Fuhua-Chen/ReSpeaker_Microphone_Array_SCH_PCB/README.md

# ReSpeaker_ReSpeaker_Microphone_Array_SCH_PCB
SCH, PCB and assembly files of ReSpeaker Microphone Array

## Requirements  
* Eagle v6.4 or later version

## Structure
* Folder SCH&PCB: sch, PCB and pdf built by Eagle
* Folder Assembly: Gerber, SMT coordinate, Assembly drawings
