Fuhua-Chen/ReSpeaker_Microphone_Array_SCH_PCB/assembly/319011550_PCB;Respeaker Microhone Array v1.0-哑光黑油白字-4层_元件位置图顶层.pdf

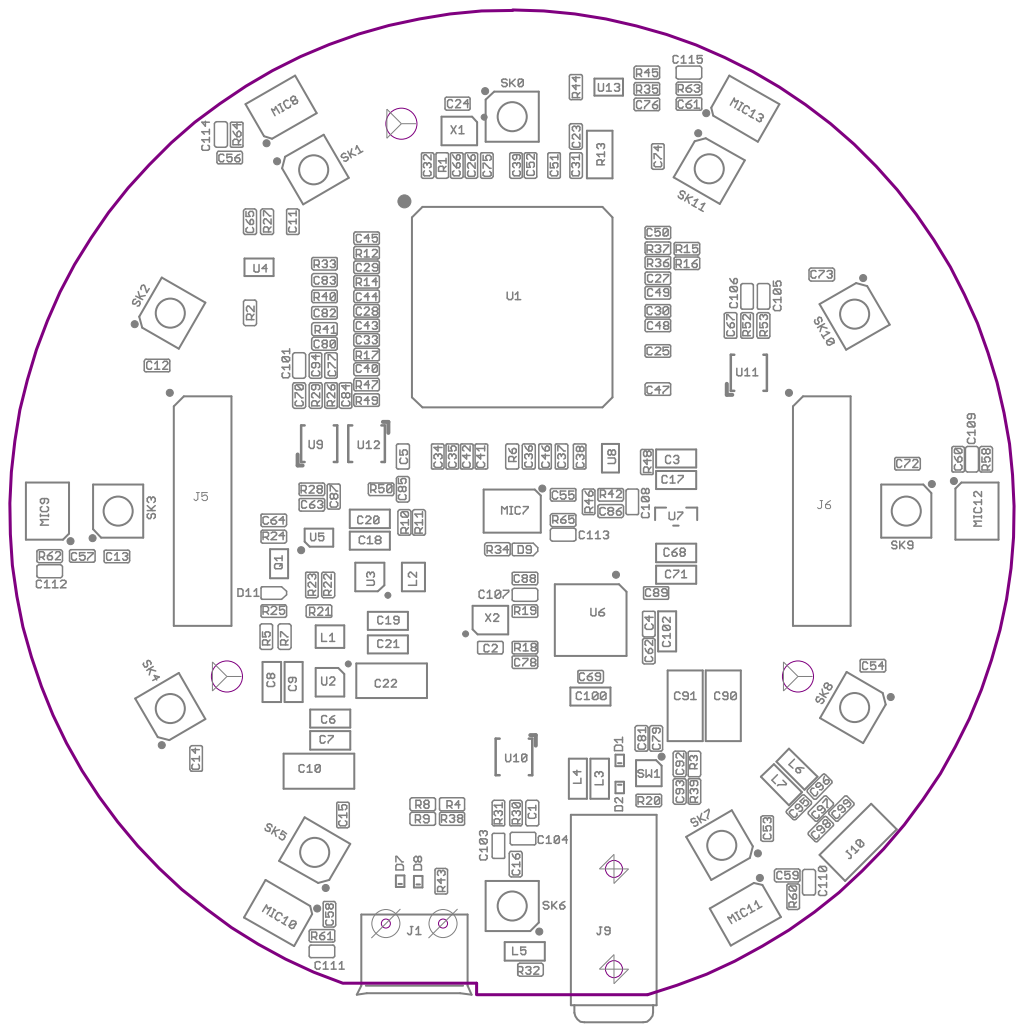
[picture p2: page 1]
