Fuhua-Chen/ReSpeaker_Microphone_Array_SCH_PCB/SCH&PCB/Respeaker Microphone Array v1.0.pdf

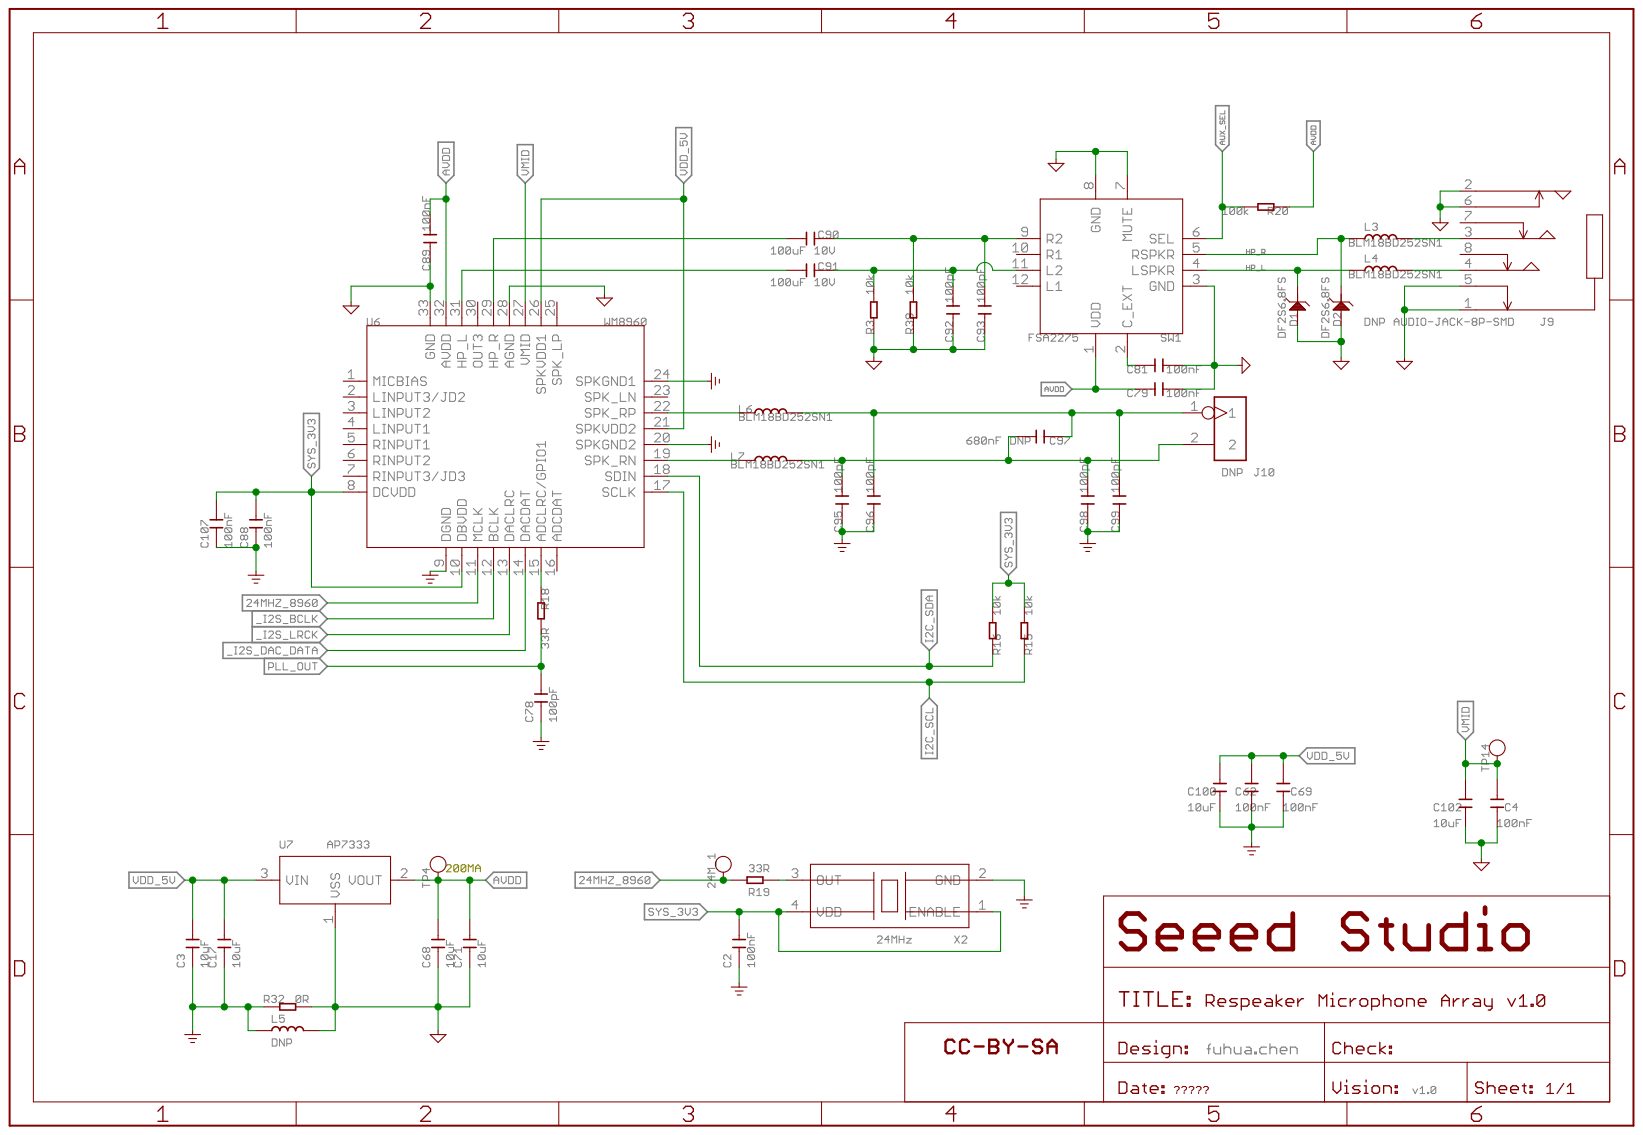
[picture p3: page 1]

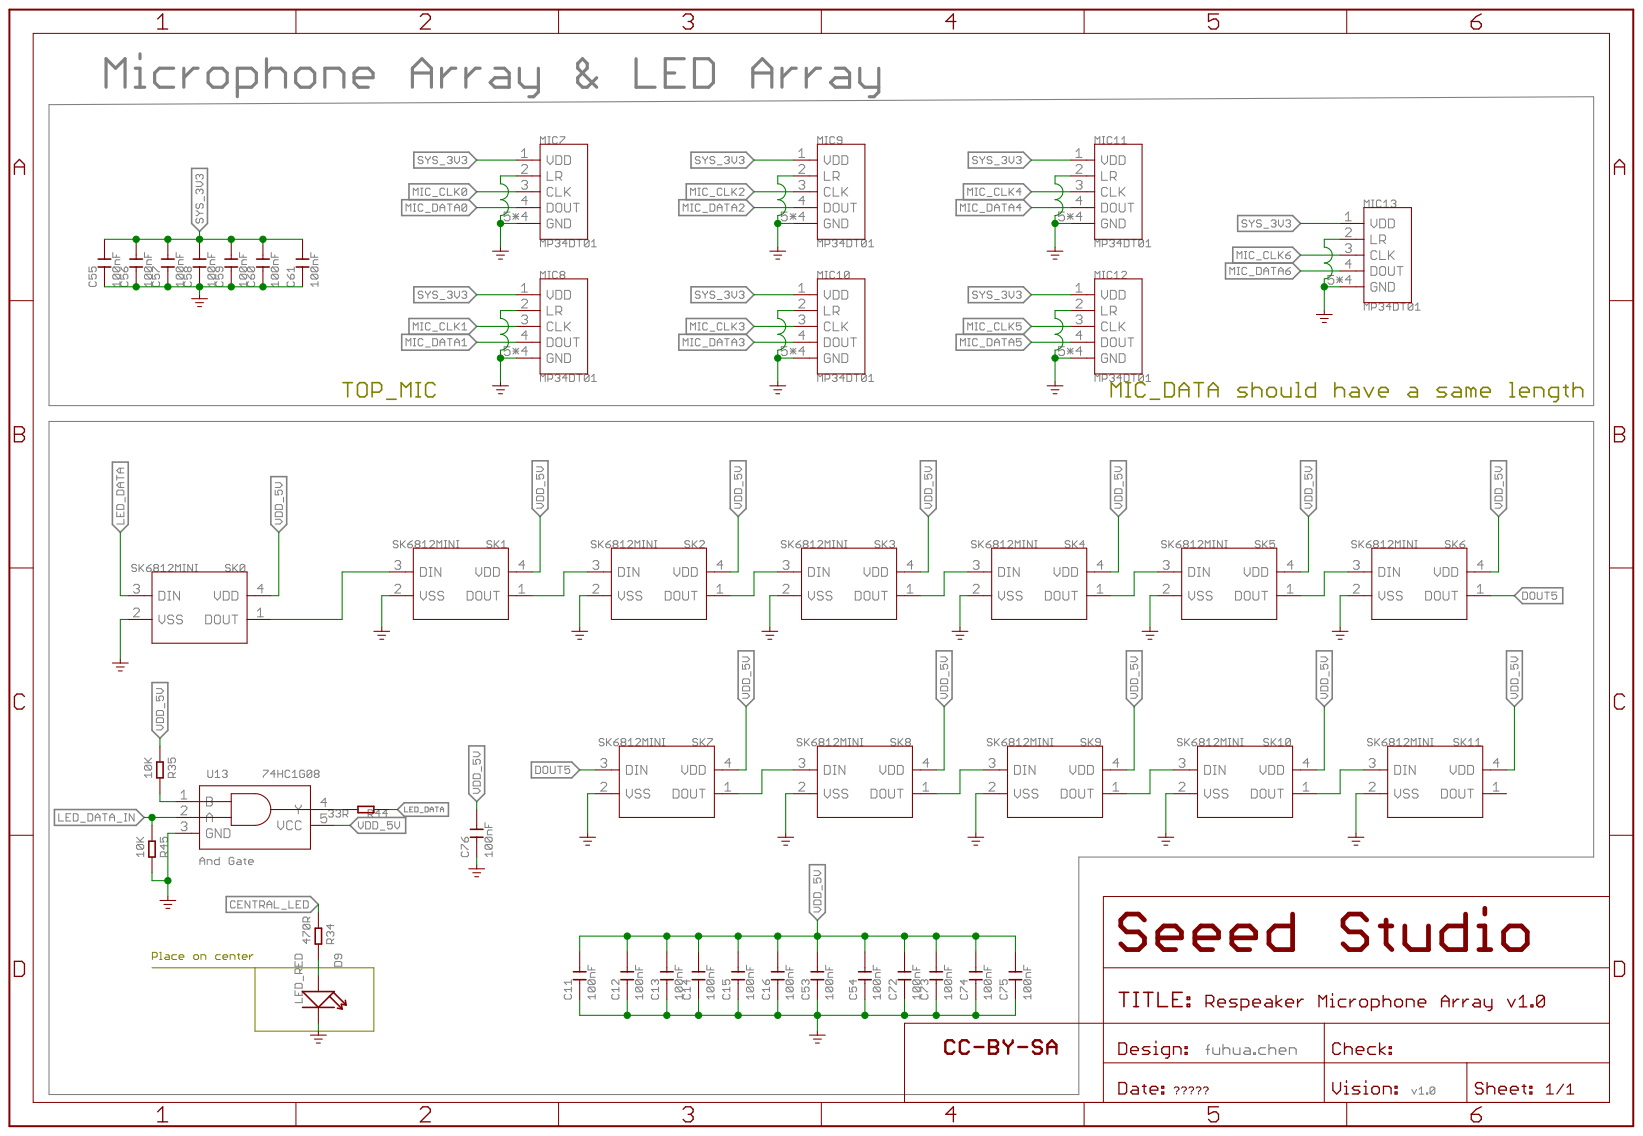
[picture p4: page 2]

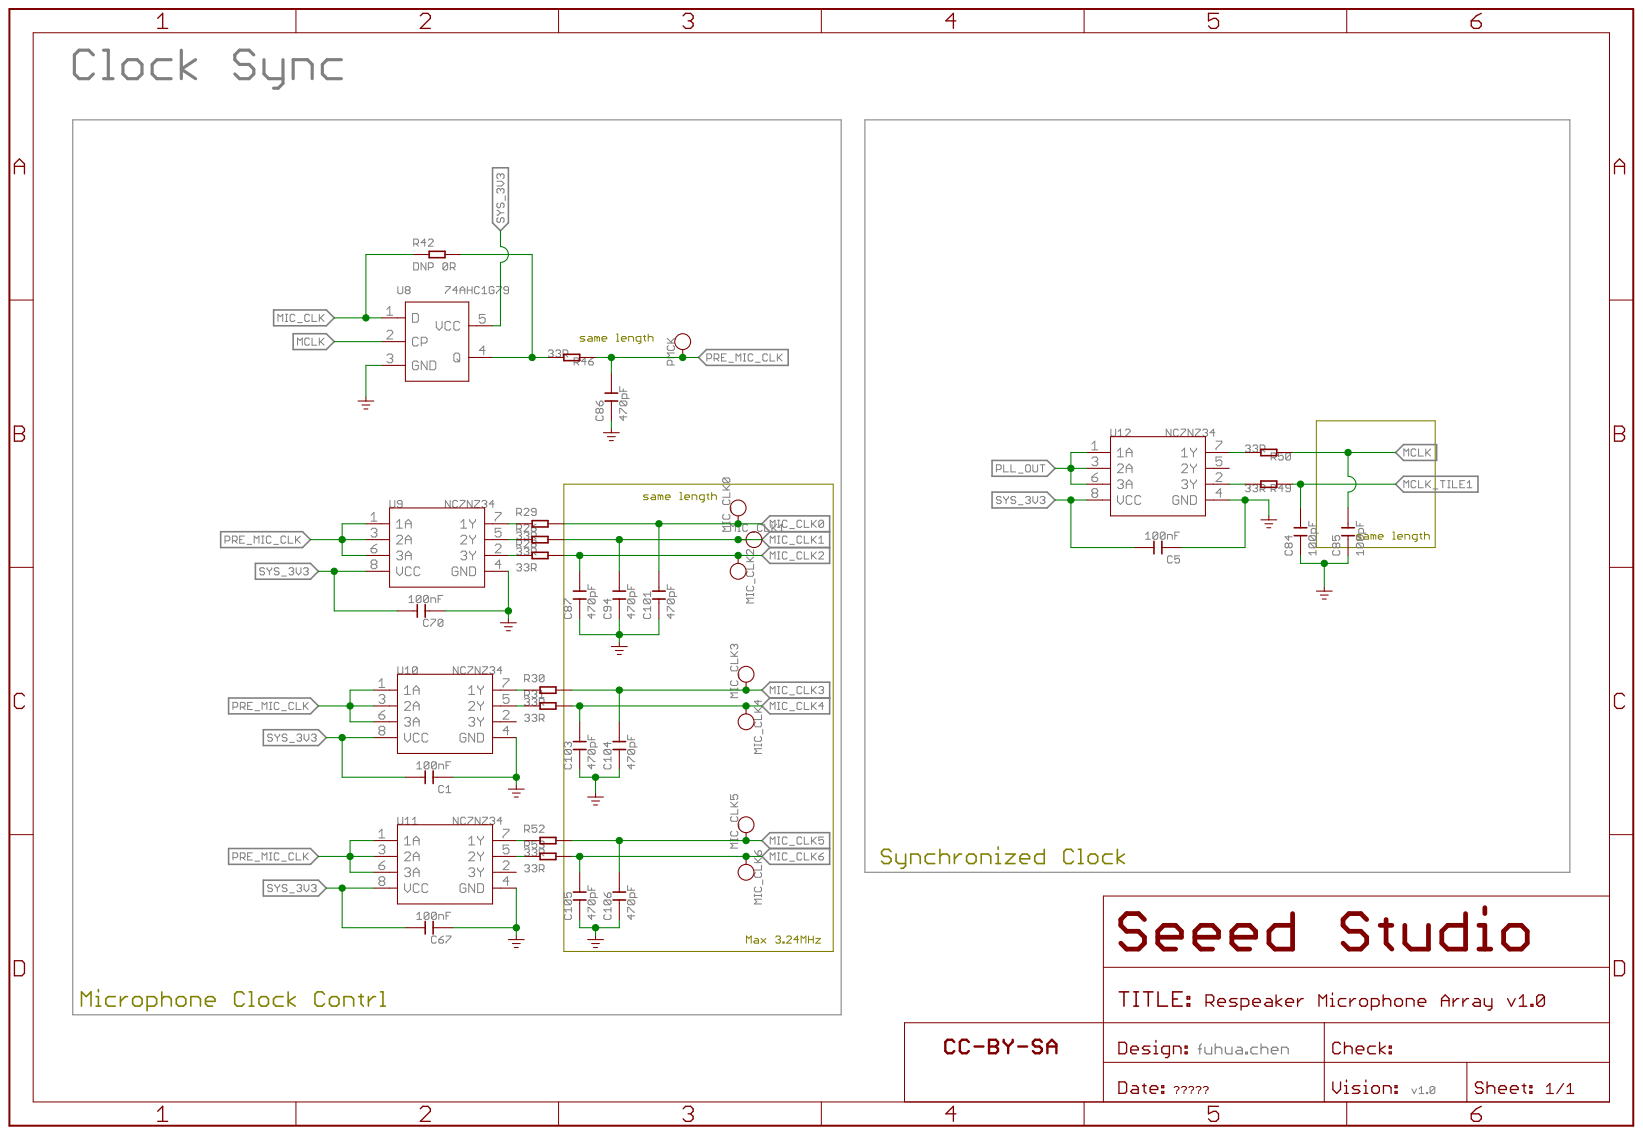
[picture p5: page 3]

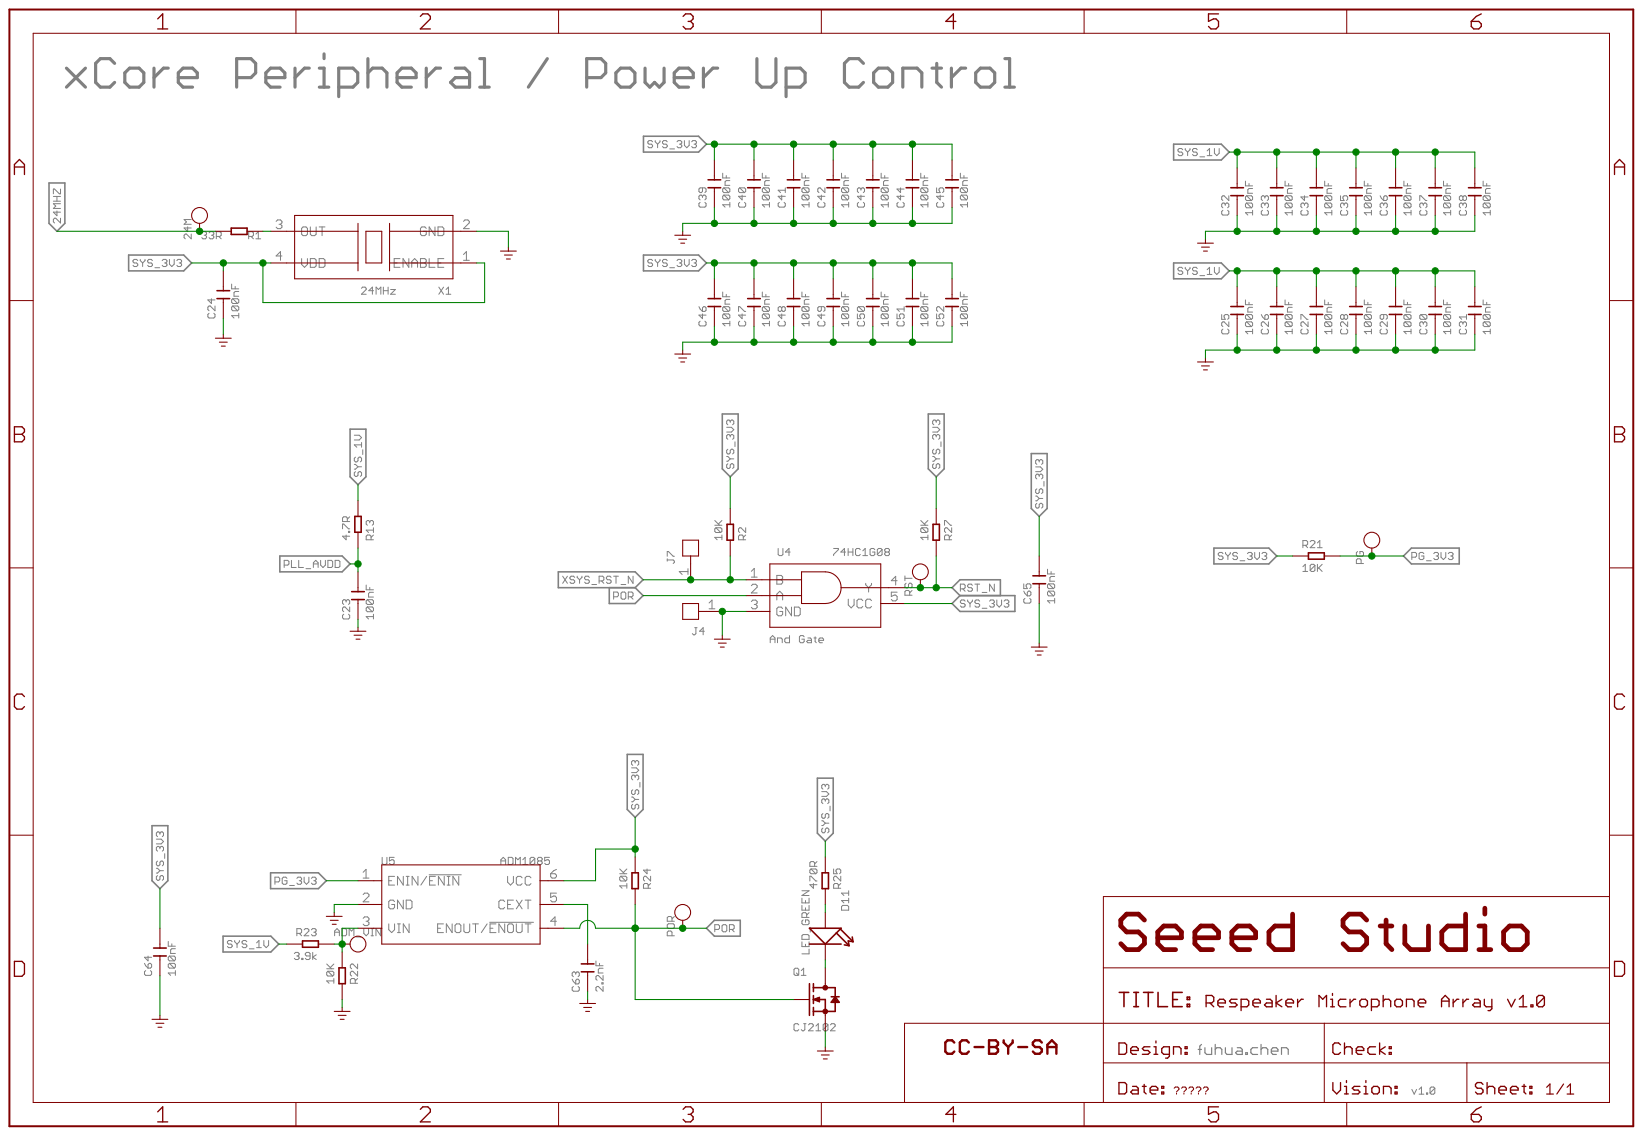
[picture p6: page 4]

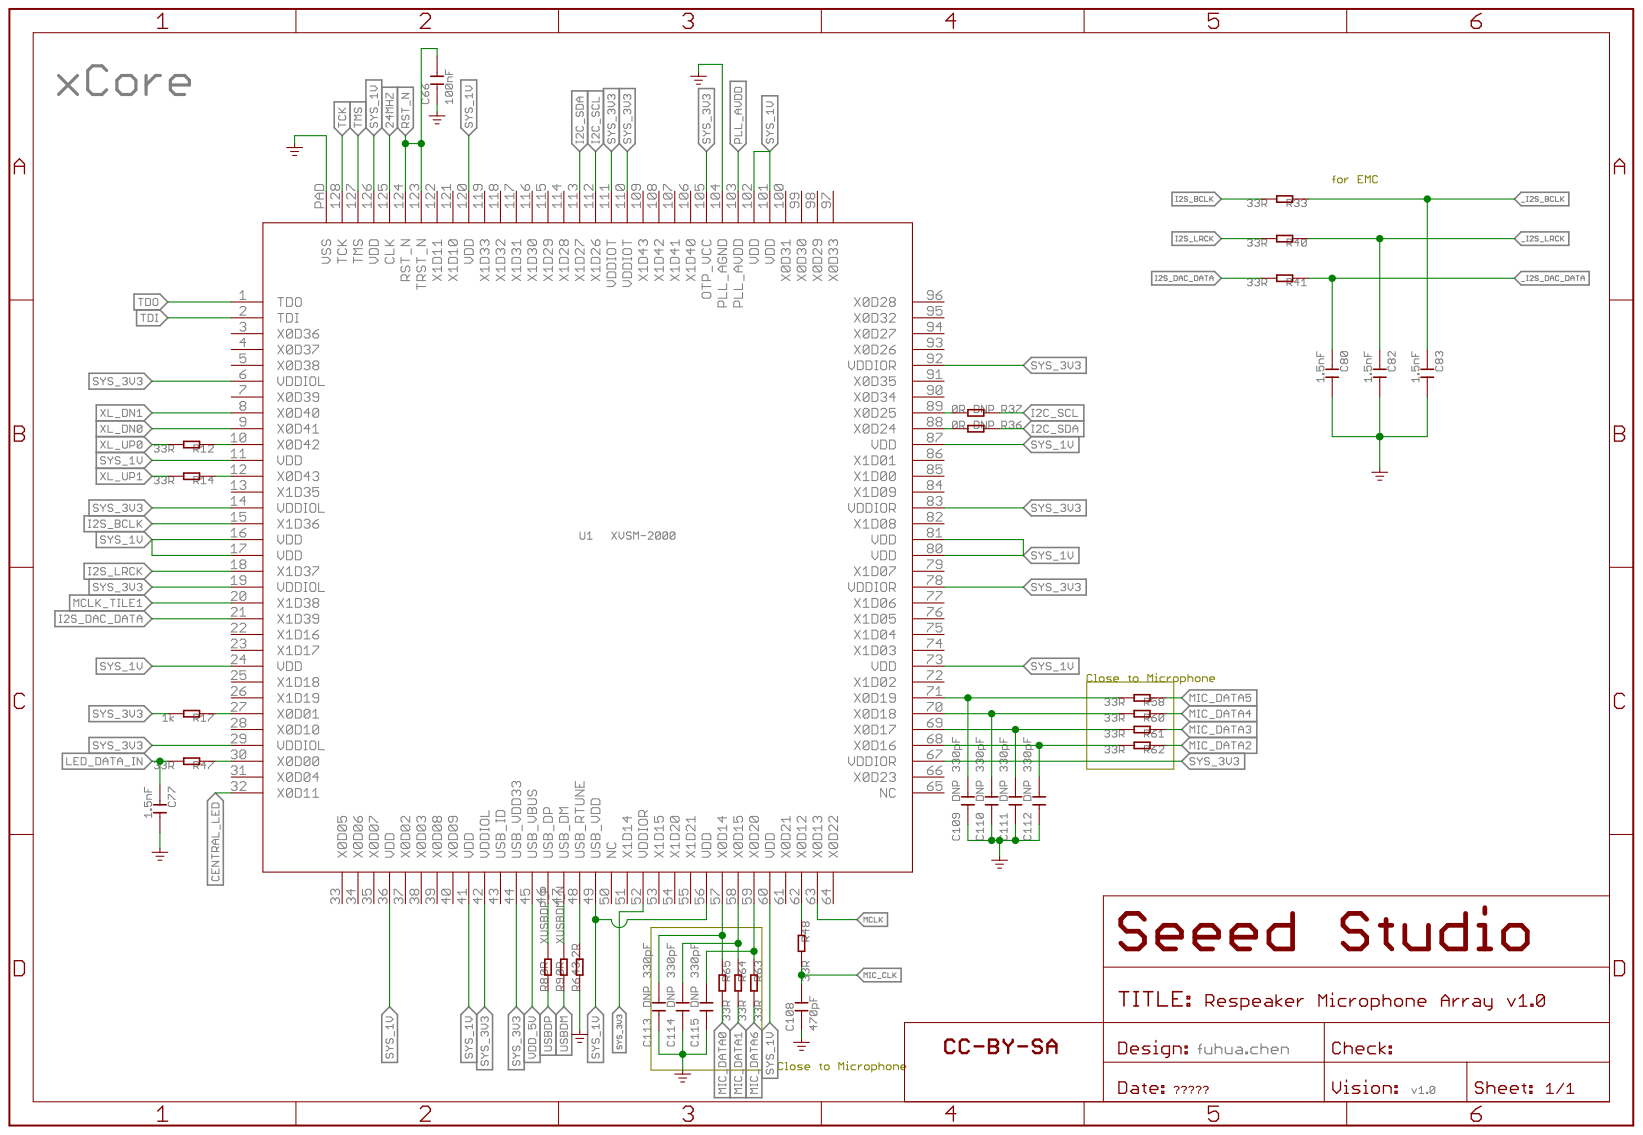
[picture p7: page 5]

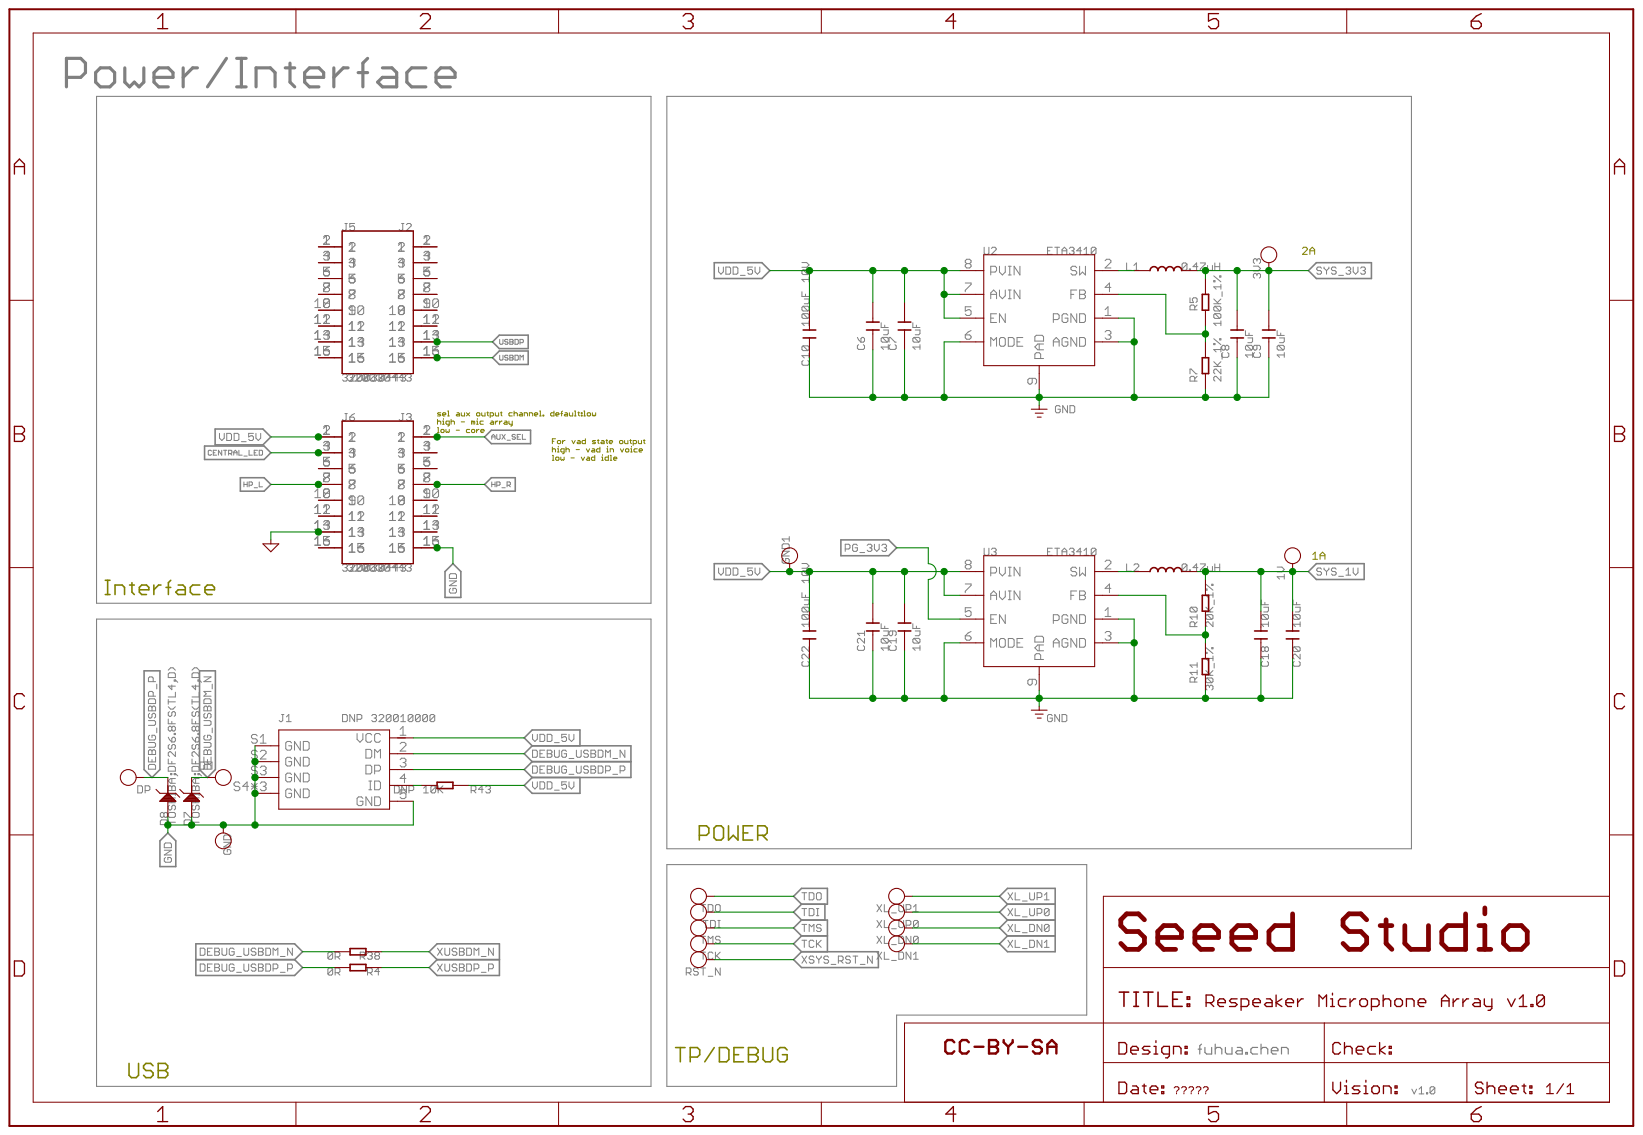
[picture p8: page 6]

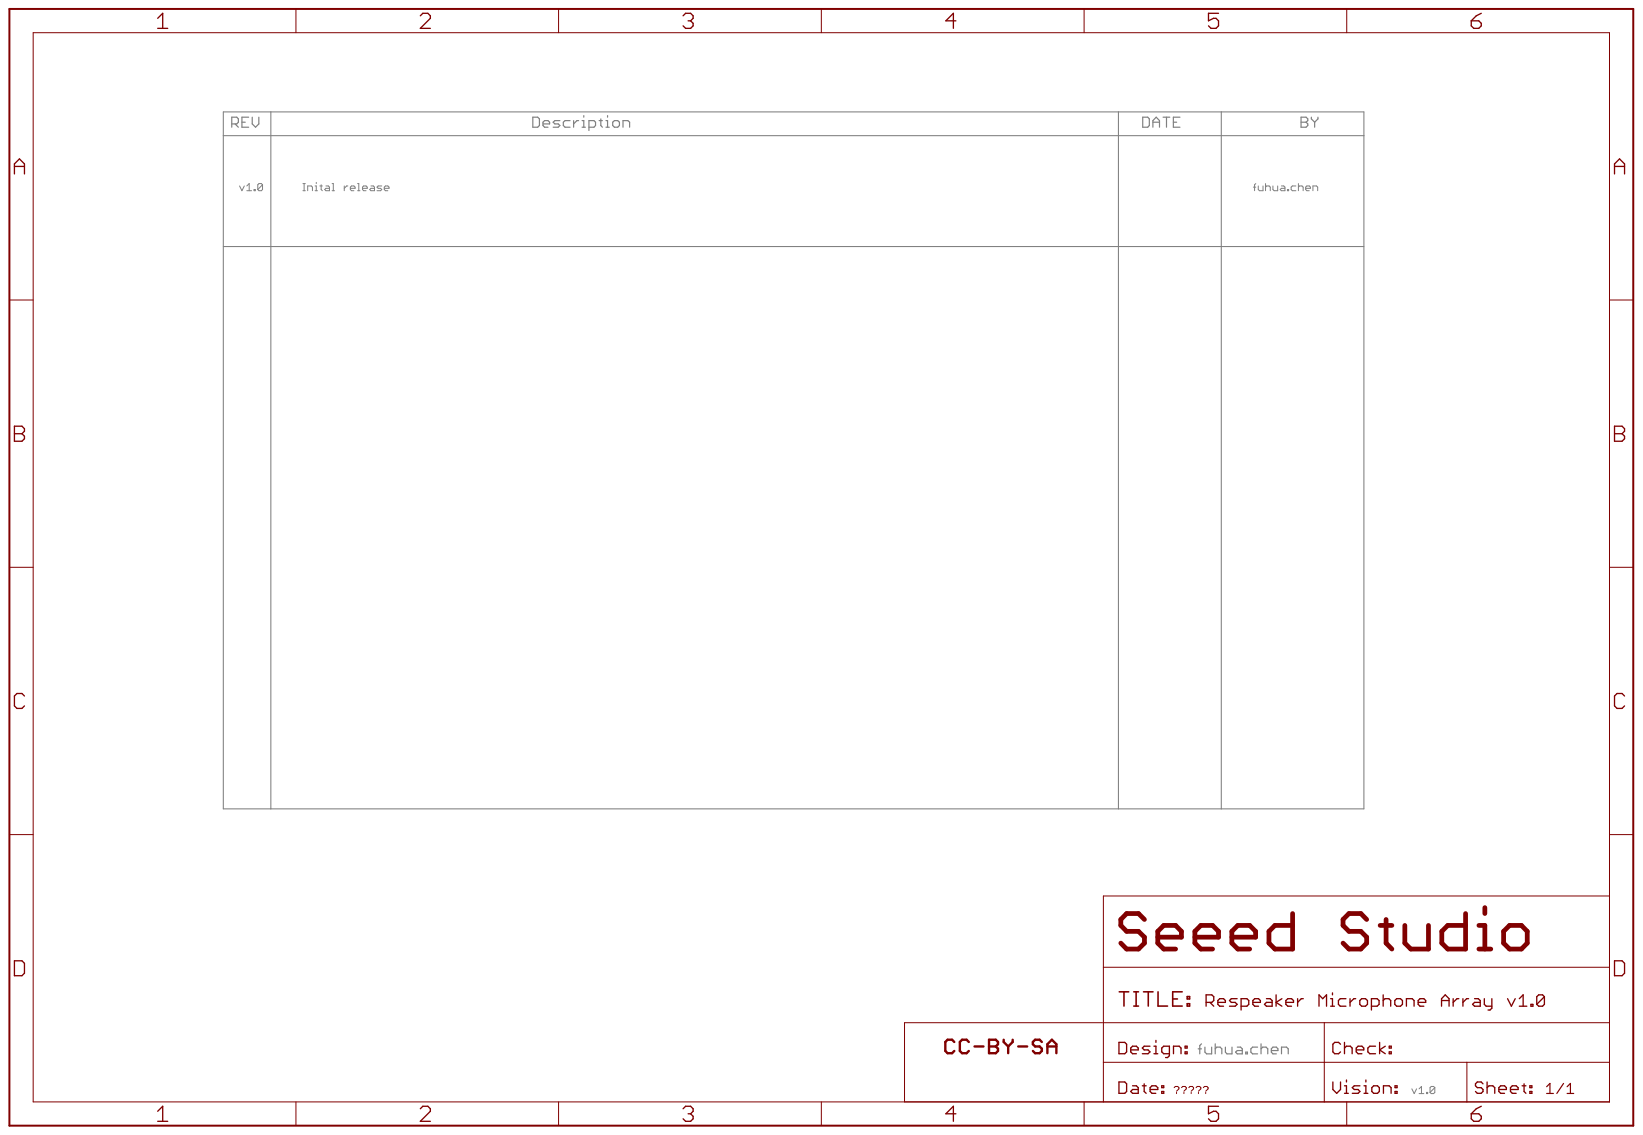
[picture p9: page 7]
