Fuhua-Chen/ReSpeaker_Microphone_Array_SCH_PCB/SCH&PCB/Respeaker Microphone Array v1.0.brd

## EAGLE design SCH&PCB/Respeaker Microphone Array v1.0.brd (2017-02-06)

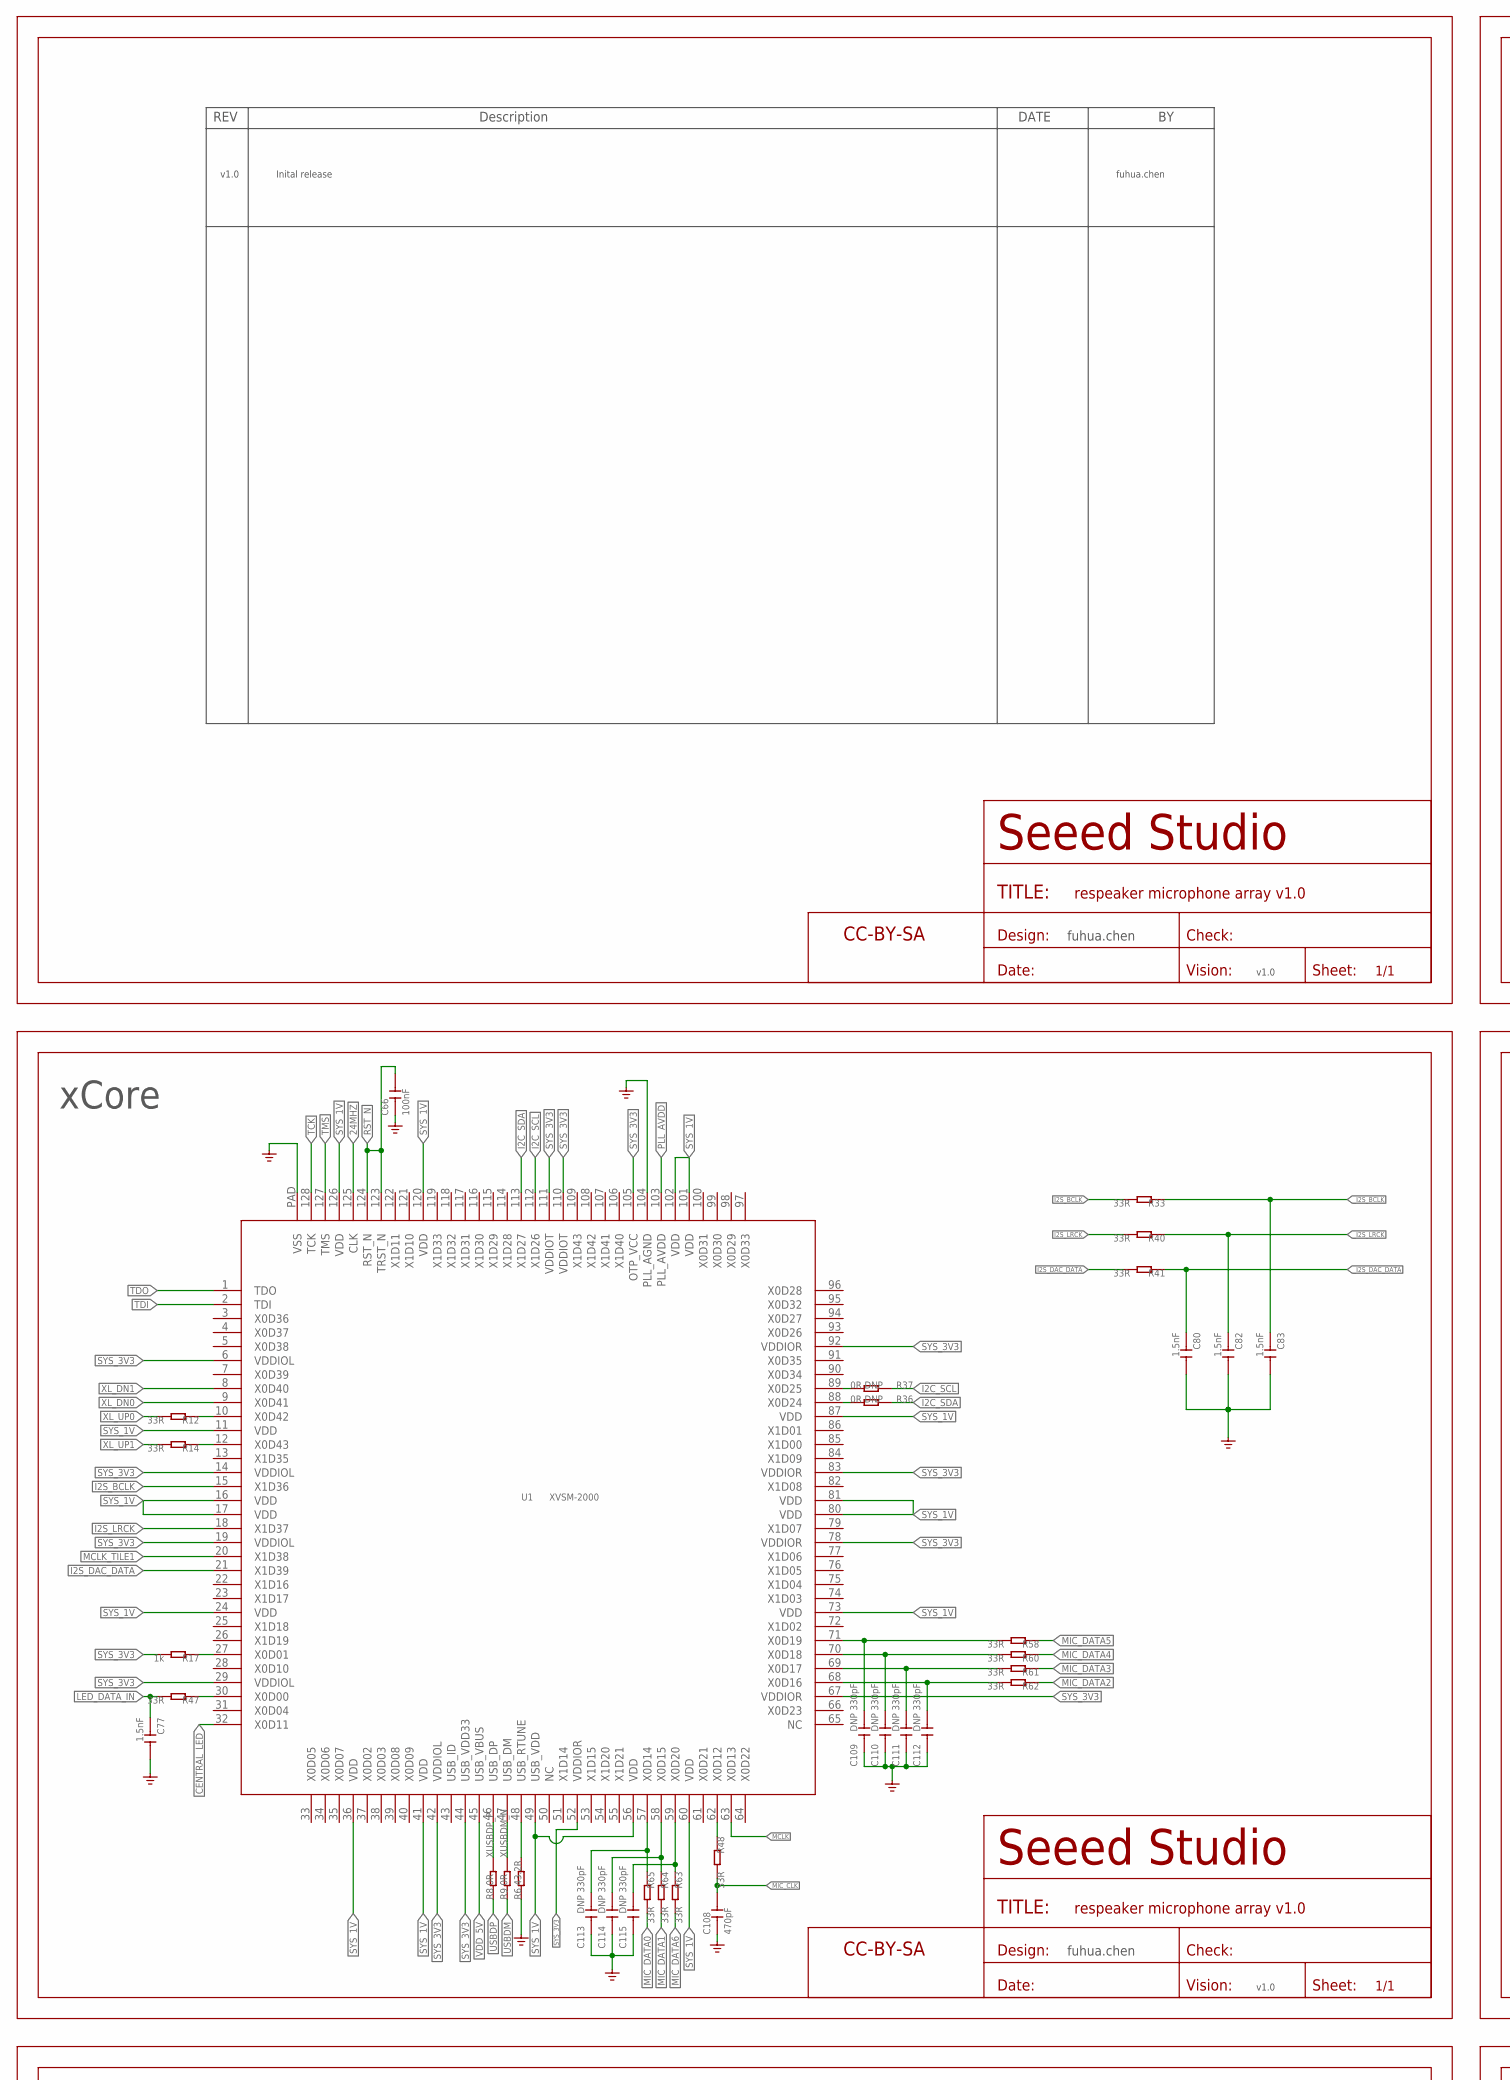
[picture p10: schematic Respeaker Microphone Array v1.0.sch, part in row 1, column 1]

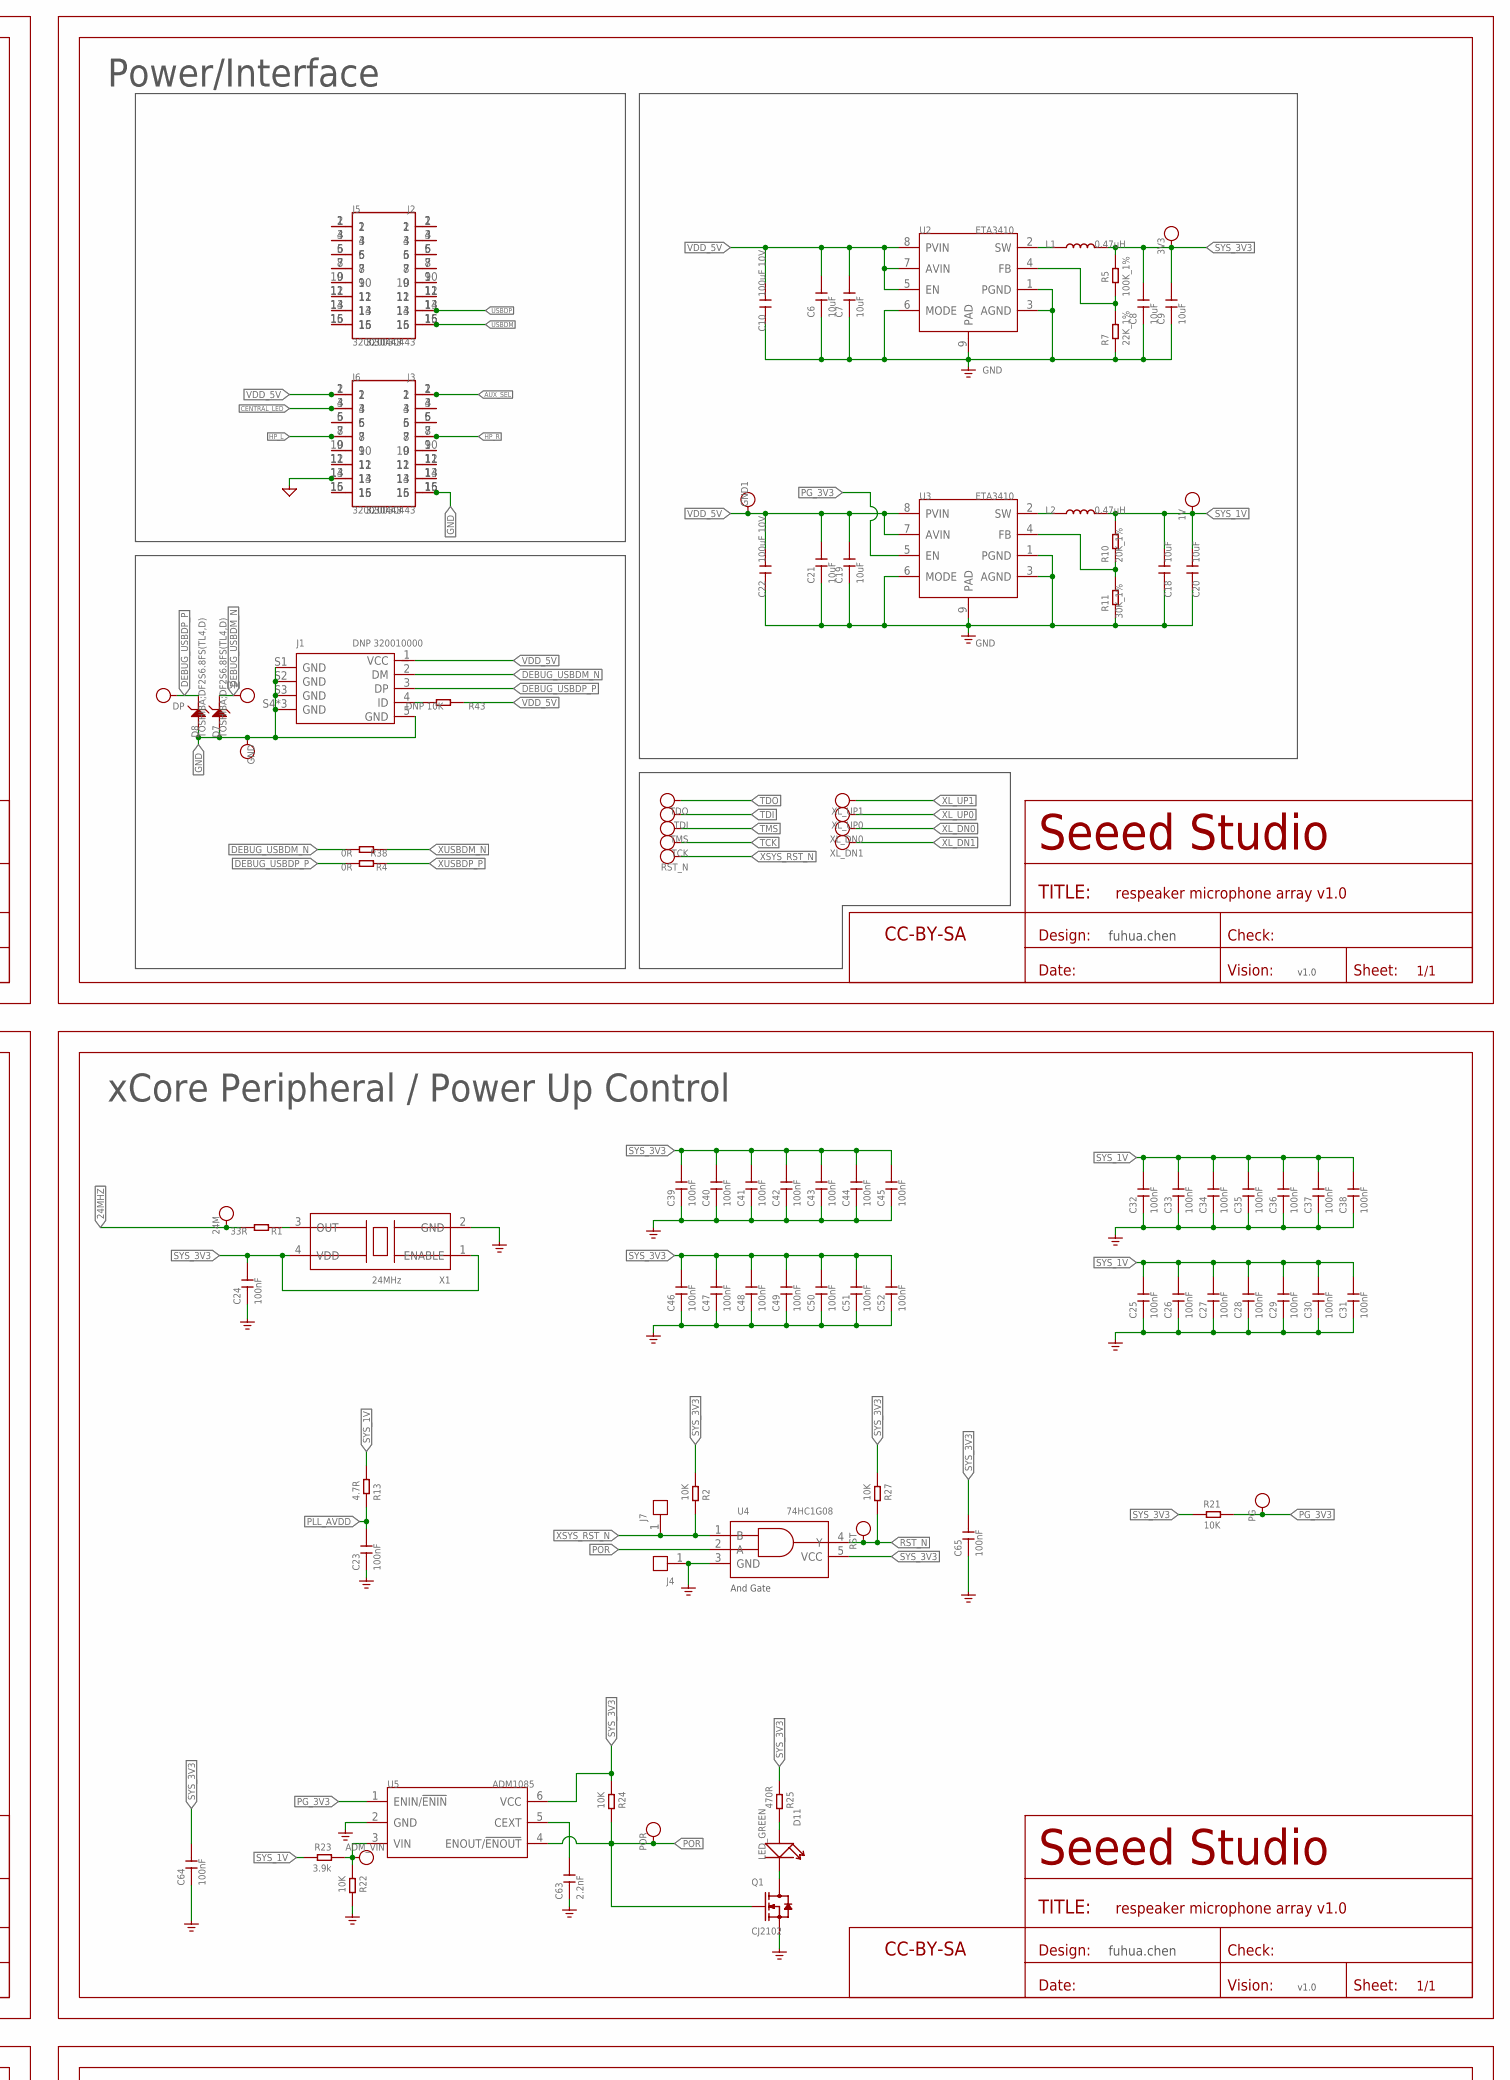
[picture p11: schematic Respeaker Microphone Array v1.0.sch, part in row 1, column 2]

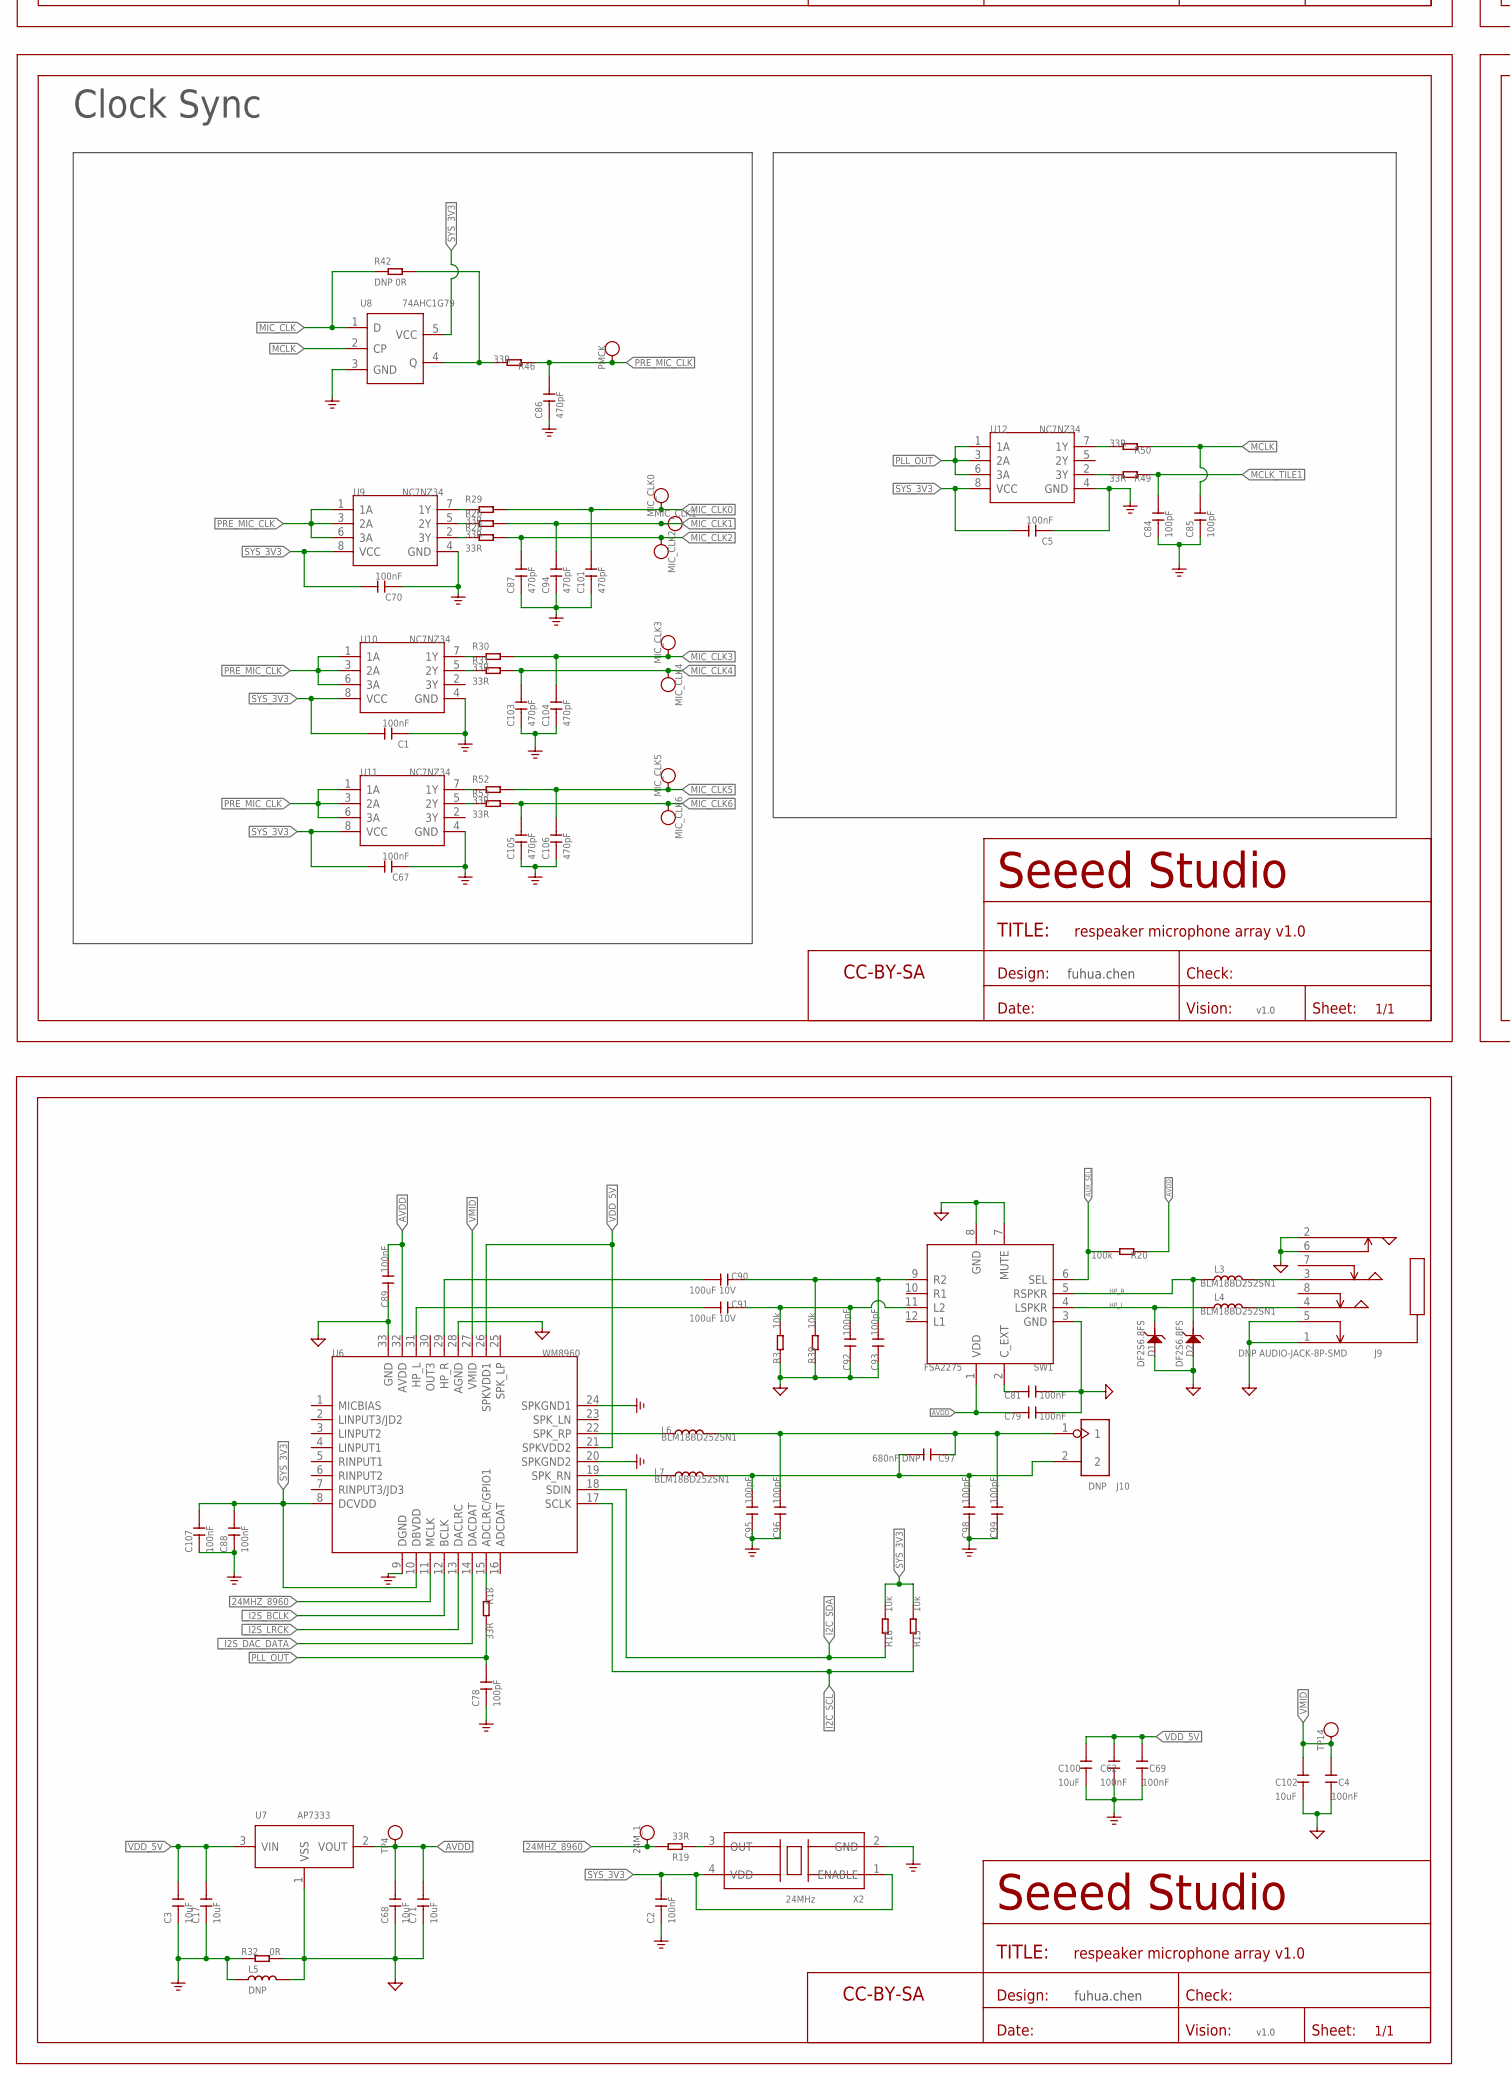
[picture p12: schematic Respeaker Microphone Array v1.0.sch, part in row 2, column 1]

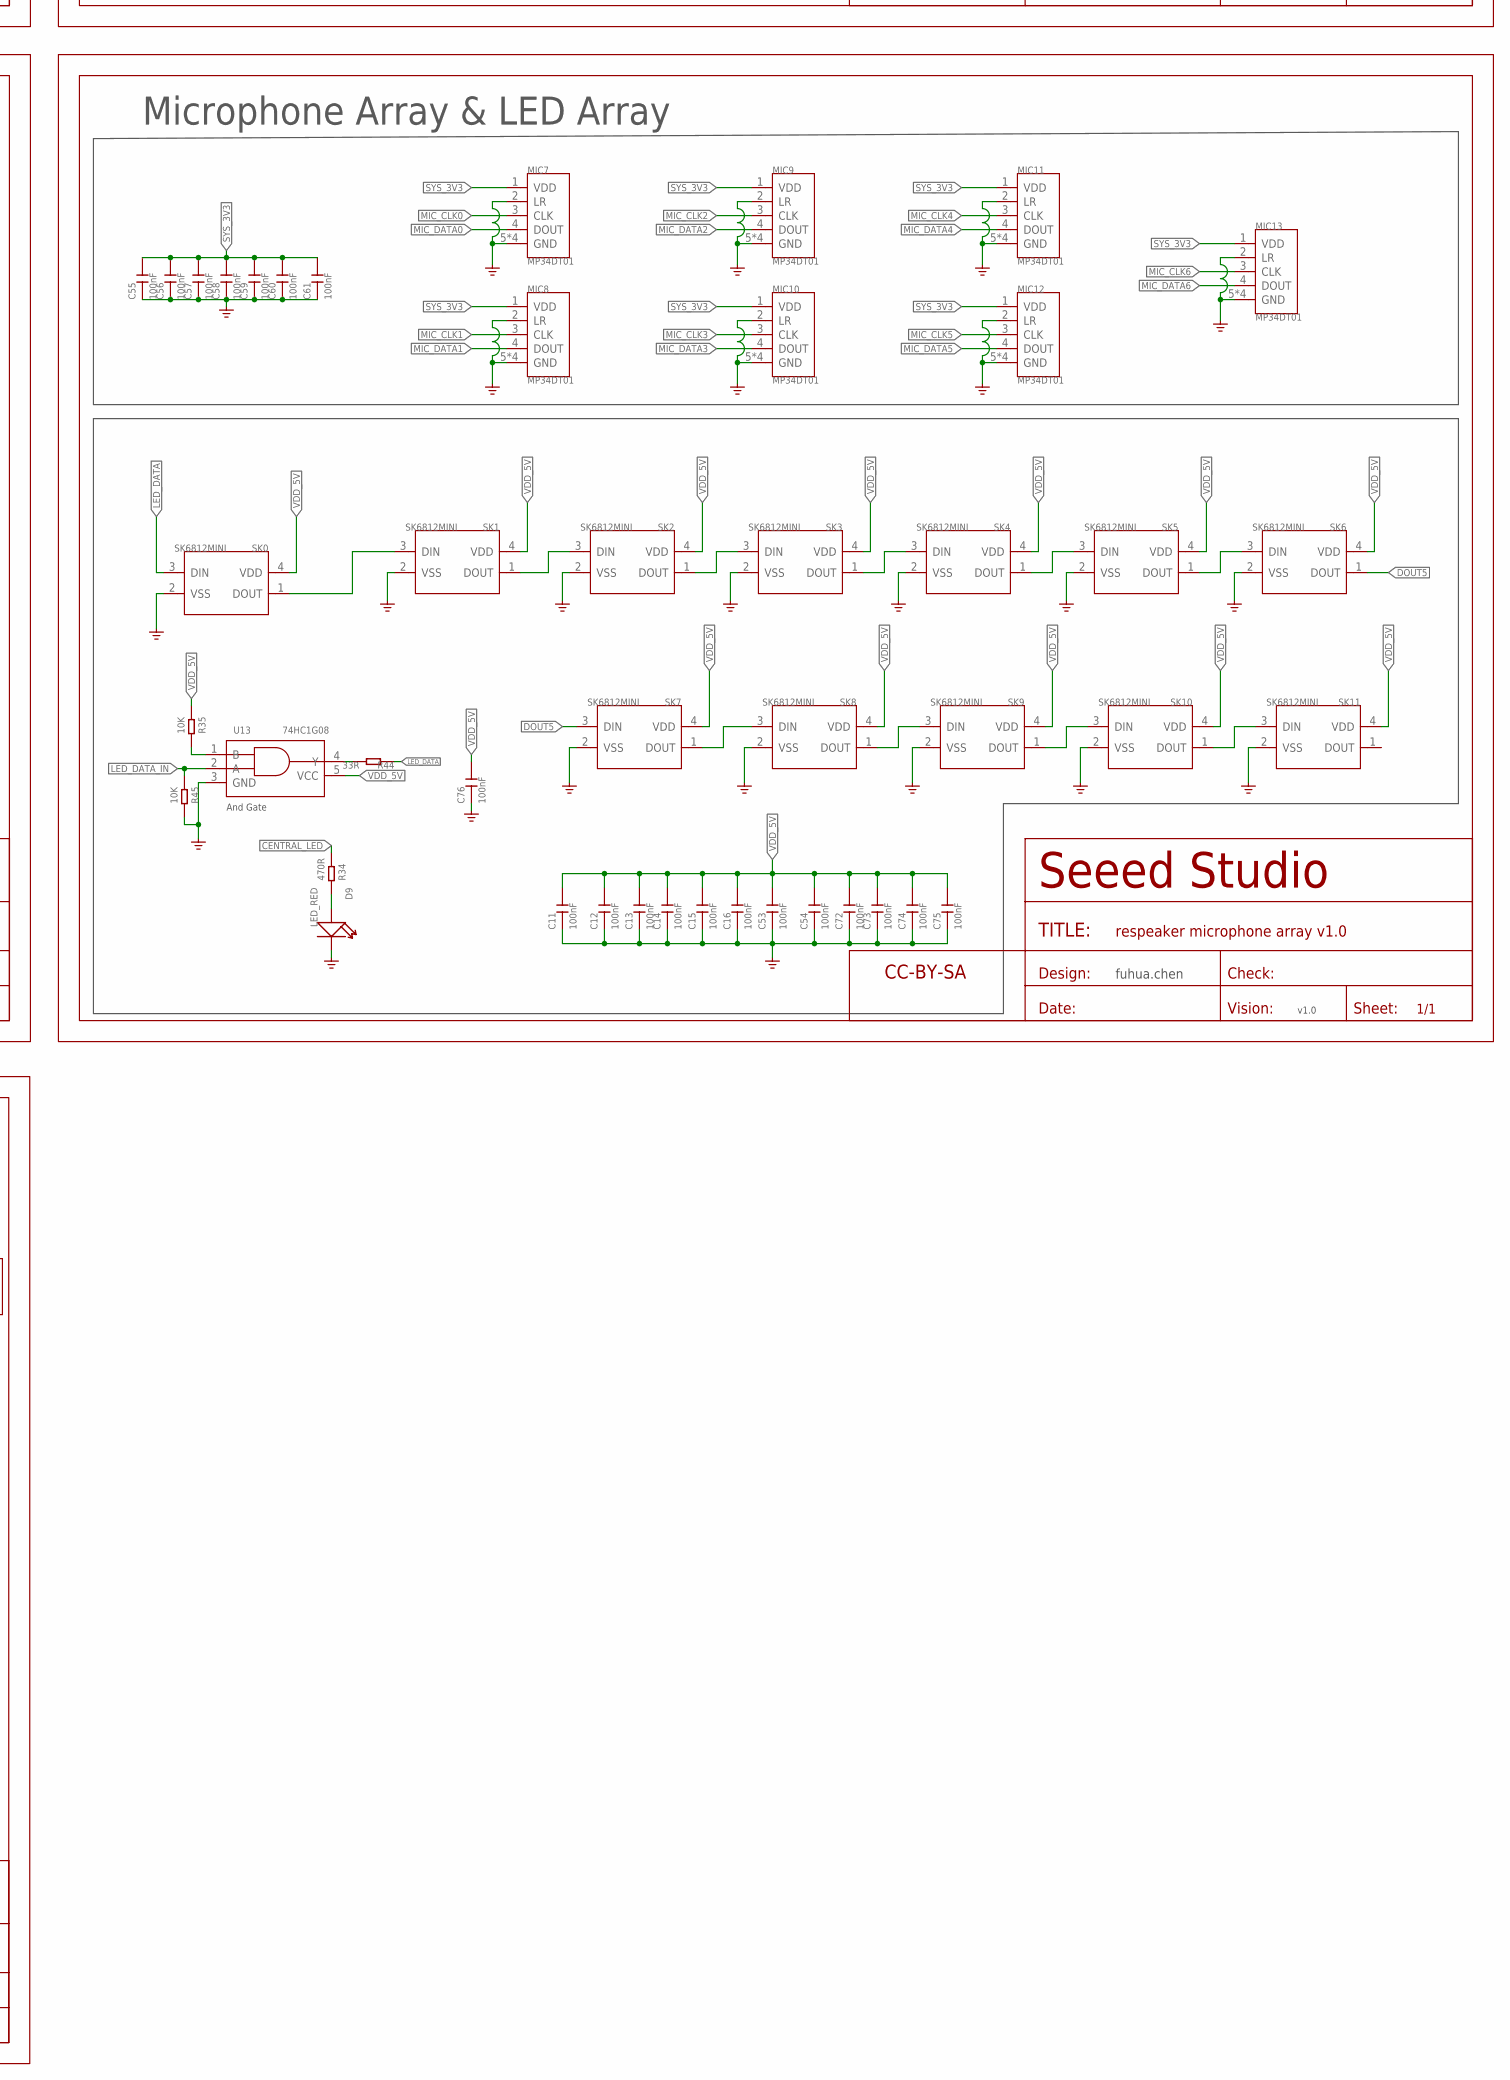
[picture p13: schematic Respeaker Microphone Array v1.0.sch, part in row 2, column 2]

Parts:
1V, 3V3, 24M, 24M_1: TEST-POINT'4545'; TP-D45MIL
ADM_VIN: TEST-POINT'4545'; TP-D45MIL
C1, C2, C4, C5, C11, C12, C13, C14, C15, C16, C23, C24, C25, C26, C27, C28, C29, C30, C31, C32, C33, C34, C35, C36, C37, C38, C39, C40, C41, C42, C43, C44, C45, C46, C47, C48, C49, C50, C51, C52, C53, C54, C55, C56, C57, C58, C59, C60, C61, C62, C64, C65, C66, C67, C69, C70, C72, C73, C74, C75, C76, C79, C81, C88, C89, C107: 100nF; C0402
C3, C6, C7, C8, C9, C17, C18, C19, C20, C21, C68, C71, C100, C102: 10uF; C0603
C10, C22, C90, C91: 100uF 10V; C1206
C63: 2.2nF; C0402
C77, C80, C82, C83: 1.5nF; C0402
C78, C84, C85, C92, C93, C95, C96, C98, C99: 100pF; C0402
C86, C87, C94, C101, C103, C104, C105, C106, C108: 470pF; C0402
C97: 680nF DNP; C0402
C109, C110, C111, C112, C113, C114, C115: DNP 330pF; C0402
D1, D2: DF2S6.8FS; SOD-923
D7, D8: TOSHIBA;DF2S6.8FS(TL4,D); SOD-923
D9: LED_RED; LED-0402
D11: LED_GREEN; LED-0402
DM: TEST-POINT'4545'; TP-D45MIL
DP: TEST-POINT'4545'; TP-D45MIL
FR1, FR2, FR3, FR4, FR5, FR7, FR8: SEEEDSTUDIO-OPEN-SCH-FRAME; SEEEDSTUDIO-PCB-FRAME
GND, GND1: TEST-POINT'4545'; TP-D45MIL
J1: DNP 320010000; MICRO-USB5+4P-SMD-0.65-B
J2, J3, J5, J6: 320030443; H2X8-SMD-2.0
J4, J7: HEADER-1P'20'; 1P-40/25MIL
J9: DNP AUDIO-JACK-8P-SMD; AUDIO8P-SMD-3.5-14.5X6.1X4.0MM
J10: DNP; H2-2.54
L1, L2: 0.47uH; L201610
L3, L4, L6, L7: BLM18BD252SN1; L0603
L5: DNP; L0603
MIC7, MIC8, MIC9, MIC10, MIC11, MIC12, MIC13: MP34DT01; HCLGA5P-3X4X1MM
MIC_CLK0, MIC_CLK1, MIC_CLK2, MIC_CLK3, MIC_CLK4, MIC_CLK5, MIC_CLK6: TEST-POINT'4545'; TP-D45MIL
PG: TEST-POINT'4545'; TP-D45MIL
PMCK: TEST-POINT'4545'; TP-D45MIL
POR: TEST-POINT'4545'; TP-D45MIL
Q1: CJ2102; SOT-323
R1, R12, R14, R18, R19, R26, R28, R29, R30, R31, R33, R40, R41, R44, R46, R47, R48, R49, R50, R52, R53, R58, R60, R61, R62, R63, R64, R65: 33R; R0402
R2, R21, R22, R24, R27, R35, R45: 10K; R0402
R3, R15, R16, R39: 10k; R0402
R4, R8, R9, R32, R38: 0R; R0402
R5: 100K_1%; R0402
R6: 43.2R; R0402
R7: 22K_1%; R0402
R10: 20K_1%; R0402
R11: 30K_1%; R0402
R13: 4.7R; R0805
R17: 1k; R0402
R20: 100k; R0402
R23: 3.9k; R0402
R25, R34: 470R; R0402
R36, R37: 0R DNP; R0402
R42: DNP 0R; R0402
R43: DNP 10K; R0402
RST: TEST-POINT'4545'; TP-D45MIL
RST_N: TEST-POINT'4545'; TP-D45MIL
SK0, SK1, SK2, SK3, SK4, SK5, SK6, SK7, SK8, SK9, SK10, SK11: SK6812MINI; LED4-SMD-3.5X3.7MM
SW1: FSA2275; LEAD12P-SMD-0.4-1.8X1.8X0.5MM
TCK: TEST-POINT'4545'; TP-D45MIL
TDI: TEST-POINT'4545'; TP-D45MIL
TDO: TEST-POINT'4545'; TP-D45MIL
TMS: TEST-POINT'4545'; TP-D45MIL
TP4, TP14: TEST-POINT'4545'; TP-D45MIL
U1: XVSM-2000; TQFP128-0.4-14X14MM
U2, U3: ETA3410; DFN8G-0.5-2X2MM
U4, U13: 74HC1G08; SOT-353
U5: ADM1085; SC-70-6
U6: WM8960; QFN32G-0.5-5X5MM
U7: AP7333; SOT-23
U8: 74AHC1G79; SOT-353
U9, U10, U11, U12: NC7NZ34; US-8
X1, X2: 24MHz; OSC-SMD-2.5X2.0X0.9MM
XL_DN0, XL_DN1: TEST-POINT'4545'; TP-D45MIL
XL_UP0, XL_UP1: TEST-POINT'4545'; TP-D45MIL

Connections:
24MHZ: 24M.T, R1.2, U1.125 (CLK)
24MHZ_8960: 24M_1.T, R19.2, U6.11 (MCLK)
$123: C90.1, U6.29 (HP_R)
$124: C91.1, U6.31 (HP_L)
AGND: C4.1, C68.1, C71.1, C79.1, C81.1, C89.1, C92.1, C93.1, C102.2, D1.2 (1), D2.2 (1), J3.14, J6.13, J9.1, J9.2, J9.5, J9.6, L5.2, R3.1, R32.2, R39.1, SW1.3 (GND), SW1.7 (MUTE), SW1.8 (GND), U6.28 (AGND), U6.33 (GND), U7.1 (VSS)
AUX_SEL: J3.1, J6.2, R20.2, SW1.6 (SEL)
AVDD: C68.2, C71.2, C79.2, C89.2, R20.1, SW1.1 (VDD), TP4.T, U6.32 (AVDD), U7.2 (VOUT)
CENTRAL_LED: J3.4, J6.3, R34.2, U1.32 (X0D11)
DEBUG_USBDM_N: D7.1 (2), DM.T, J1.2 (DM), R38.2
DEBUG_USBDP_P: D8.1 (2), DP.T, J1.3 (DP), R4.2
DOUT5: SK6.1 (DOUT), SK7.3 (DIN)
GND: C1.1, C2.1, C3.1, C5.1, C6.1, C7.1, C8.1, C9.1, C10.1, C11.1, C12.1, C13.1, C14.1, C15.1, C16.1, C17.1, C18.1, C19.1, C20.1, C21.1, C22.1, C23.1, C24.1, C25.1, C26.1, C27.1, C28.1, C29.1, C30.1, C31.1, C32.1, C33.1, C34.1, C35.1, C36.1, C37.1, C38.1, C39.1, C40.1, C41.1, C42.1, C43.1, C44.1, C45.1, C46.1, C47.1, C48.1, C49.1, C50.1, C51.1, C52.1, C53.1, C54.1, C55.1, C56.1, C57.1, C58.1, C59.1, C60.1, C61.1, C62.1, C63.1, C64.1, C65.1, C66.1, C67.1, C69.1, C70.1, C72.1, C73.1, C74.1, C75.1, C76.1, C77.2, C78.1, C80.2, C82.2, C83.2, C84.1, C85.1, C86.1, C87.1, C88.1, C94.1, C95.1, C96.1, C98.1, C99.1, C100.2, C101.1, C103.1, C104.1, C105.1, C106.1, C107.1, C108.1, C109.1, C110.1, C111.1, C112.1, C113.1, C114.1, C115.1, D7.2 (1), D8.2 (1), D9.-, GND.T, J1.5 (GND), J1.S1 (GND), J1.S2 (GND), J1.S3 (GND), J1.S4 (GND), J1.S5 (GND), J1.S6 (GND), J3.15, J4.1, J6.16, L5.1, MIC7.2 (LR), MIC7.5 (GND), MIC7.6 (GND), MIC7.7 (GND), MIC7.8 (GND), MIC8.2 (LR), MIC8.5 (GND), MIC8.6 (GND), MIC8.7 (GND), MIC8.8 (GND), MIC9.2 (LR), MIC9.5 (GND), MIC9.6 (GND), MIC9.7 (GND), MIC9.8 (GND), MIC10.2 (LR), MIC10.5 (GND), MIC10.6 (GND), MIC10.7 (GND), MIC10.8 (GND), MIC11.2 (LR), MIC11.5 (GND), MIC11.6 (GND), MIC11.7 (GND), MIC11.8 (GND), MIC12.2 (LR), MIC12.5 (GND), MIC12.6 (GND), MIC12.7 (GND), MIC12.8 (GND), MIC13.2 (LR), MIC13.5 (GND), MIC13.6 (GND), MIC13.7 (GND), MIC13.8 (GND), Q1.2 (S), R6.1, R7.1, R11.1, R22.1, R32.1, R45.1, SK0.2 (VSS), SK1.2 (VSS), SK2.2 (VSS), SK3.2 (VSS), SK4.2 (VSS), SK5.2 (VSS), SK6.2 (VSS), SK7.2 (VSS), SK8.2 (VSS), SK9.2 (VSS), SK10.2 (VSS), SK11.2 (VSS), U1.104 (PLL_AGND), U1.PAD (VSS), U2.1 (PGND), U2.3 (AGND), U2.6 (MODE), U2.9 (PAD), U3.1 (PGND), U3.3 (AGND), U3.6 (MODE), U3.9 (PAD), U4.3 (GND), U5.2 (GND), U6.9 (DGND), U6.20 (SPKGND2), U6.24 (SPKGND1), U8.3 (GND), U9.4 (GND), U10.4 (GND), U11.4 (GND), U12.4 (GND), U13.3 (GND), X1.2 (GND), X2.2 (GND)
HP_L: D1.1 (2), J3.8, J6.7, L4.1, SW1.4 (LSPKR)
HP_R: D2.1 (2), J3.7, J6.8, L3.1, SW1.5 (RSPKR)
I2C_SCL: R15.1, R37.1, U1.112 (X1D26), U6.17 (SCLK)
I2C_SDA: R16.1, R36.1, U1.113 (X1D27), U6.18 (SDIN)
I2S_BCLK: R33.2, U1.15 (X1D36)
I2S_DAC_DATA: R41.2, U1.21 (X1D39)
I2S_LRCK: R40.2, U1.18 (X1D37)
LED_DATA: R44.1, SK0.3 (DIN)
LED_DATA_IN: C77.1, R45.2, R47.2, U13.2 (A)
MCLK: C85.2, R50.1, U1.63 (X0D13), U8.2 (CP)
MCLK_TILE1: C84.2, R49.1, U1.20 (X1D38)
MIC_CLK: C108.2, R42.1, R48.2, U8.1 (D)
MIC_CLK0: C101.2, MIC7.3 (CLK), MIC_CLK0.T, R29.2
MIC_CLK1: C94.2, MIC8.3 (CLK), MIC_CLK1.T, R26.2
MIC_CLK2: C87.2, MIC9.3 (CLK), MIC_CLK2.T, R28.2
MIC_CLK3: C104.2, MIC10.3 (CLK), MIC_CLK3.T, R30.2
MIC_CLK4: C103.2, MIC11.3 (CLK), MIC_CLK4.T, R31.2
MIC_CLK5: C106.2, MIC12.3 (CLK), MIC_CLK5.T, R52.2
MIC_CLK6: C105.2, MIC13.3 (CLK), MIC_CLK6.T, R53.2
MIC_DATA0: MIC7.4 (DOUT), R65.2
MIC_DATA1: MIC8.4 (DOUT), R64.2
MIC_DATA2: MIC9.4 (DOUT), R62.1
MIC_DATA3: MIC10.4 (DOUT), R61.1
MIC_DATA4: MIC11.4 (DOUT), R60.1
MIC_DATA5: MIC12.4 (DOUT), R58.1
MIC_DATA6: MIC13.4 (DOUT), R63.2
unnamed: R14.1, U1.12 (X0D43)
unnamed: R18.1, U6.15 (ADCLRC/GPIO1)
unnamed: L2.1, U3.2 (SW)
unnamed: R6.2, U1.48 (USB_RTUNE)
unnamed: R12.1, U1.10 (X0D42)
unnamed: R17.1, U1.27 (X0D01)
unnamed: ADM_VIN.T, R22.2, R23.1, U5.3 (VIN)
unnamed: R10.1, R11.2, U3.4 (FB)
unnamed: D11.-, Q1.3 (D)
unnamed: SK8.1 (DOUT), SK9.3 (DIN)
unnamed: R1.1, X1.3 (OUT)
unnamed: D11.+, R25.1
unnamed: SK1.1 (DOUT), SK2.3 (DIN)
unnamed: C63.2, U5.5 (CEXT)
unnamed: R28.1, U9.2 (3Y)
unnamed: R53.1, U11.5 (2Y)
unnamed: SK2.1 (DOUT), SK3.3 (DIN)
unnamed: C81.2, SW1.2 (C_EXT)
unnamed: SK3.1 (DOUT), SK4.3 (DIN)
unnamed: SK4.1 (DOUT), SK5.3 (DIN)
unnamed: R19.1, X2.3 (OUT)
unnamed: R26.1, U9.5 (2Y)
unnamed: R31.1, U10.5 (2Y)
unnamed: R29.1, U9.7 (1Y)
unnamed: R49.2, U12.2 (3Y)
unnamed: R50.2, U12.7 (1Y)
unnamed: J2.1, J5.2
unnamed: R30.1, U10.7 (1Y)
unnamed: L1.1, U2.2 (SW)
unnamed: J2.2, J5.1
unnamed: R47.1, U1.30 (X0D00)
unnamed: R5.1, R7.2, U2.4 (FB)
unnamed: R52.1, U11.7 (1Y)
unnamed: J2.3, J5.4
unnamed: C109.2, R58.2, U1.71 (X0D19)
unnamed: C110.2, R60.2, U1.70 (X0D18)
unnamed: C111.2, R61.2, U1.69 (X0D17)
unnamed: C112.2, R62.2, U1.68 (X0D16)
unnamed: C115.2, R63.1, U1.59 (X0D20)
unnamed: C114.2, R64.1, U1.58 (X0D15)
unnamed: J3.5, J6.6
unnamed: J1.4 (ID), R43.2
unnamed: SK5.1 (DOUT), SK6.3 (DIN)
unnamed: SK7.1 (DOUT), SK8.3 (DIN)
unnamed: R36.2, U1.88 (X0D24)
unnamed: SK9.1 (DOUT), SK10.3 (DIN)
unnamed: SK10.1 (DOUT), SK11.3 (DIN)
unnamed: SK0.1 (DOUT), SK1.3 (DIN)
unnamed: D9.+, R34.1
unnamed: J2.4, J5.3
unnamed: J2.5, J5.6
unnamed: R37.2, U1.89 (X0D25)
unnamed: C95.2, C97.2, C98.2, J10.2, L7.2
unnamed: J9.3, L3.2
unnamed: C90.2, C93.2, R39.2, SW1.9 (R2)
unnamed: J9.4, L4.2
unnamed: J2.6, J5.5
unnamed: J2.7, J5.8
unnamed: J2.8, J5.7
unnamed: C91.2, C92.2, R3.2, SW1.11 (L2)
unnamed: L6.1, U6.22 (SPK_RP)
unnamed: J2.9, J5.10
unnamed: J2.10, J5.9
unnamed: L7.1, U6.19 (SPK_RN)
unnamed: C96.2, C97.1, C99.2, J10.1, L6.2
unnamed: J2.11, J5.12
unnamed: J2.12, J5.11
unnamed: J2.14, J5.13
unnamed: J2.16, J5.15
unnamed: R44.2, U13.4 (Y)
unnamed: R35.1, U13.1 (B)
unnamed: J3.6, J6.5
unnamed: J3.9, J6.10
unnamed: J3.10, J6.9
unnamed: J3.11, J6.12
unnamed: J3.12, J6.11
unnamed: J3.13, J6.14
unnamed: J3.16, J6.15
unnamed: R42.2, R46.2, U8.4 (Q)
unnamed: R48.1, U1.62 (X0D12)
unnamed: C113.2, R65.1, U1.57 (X0D14)
unnamed: J3.3, J6.4
PG_3V3: PG.T, R21.1, U3.5 (EN), U5.1 (ENIN/!ENIN)
PLL_AVDD: C23.2, R13.1, U1.103 (PLL_AVDD)
PLL_OUT: C78.2, R18.2, U12.1 (1A), U12.3 (2A), U12.6 (3A)
POR: POR.T, Q1.1 (G), R24.1, U4.2 (A), U5.4 (ENOUT/!ENOUT)
PRE_MIC_CLK: C86.2, PMCK.T, R46.1, U9.1 (1A), U9.3 (2A), U9.6 (3A), U10.1 (1A), U10.3 (2A), U10.6 (3A), U11.1 (1A), U11.3 (2A), U11.6 (3A)
RST_N: C66.2, R27.1, RST.T, U1.123 (TRST_N), U1.124 (RST_N), U4.4 (Y)
SYS_1V: 1V.T, C18.2, C20.2, C25.2, C26.2, C27.2, C28.2, C29.2, C30.2, C31.2, C32.2, C33.2, C34.2, C35.2, C36.2, C37.2, C38.2, L2.2, R10.2, R13.2, R23.2, U1.11 (VDD), U1.16 (VDD), U1.17 (VDD), U1.24 (VDD), U1.36 (VDD), U1.41 (VDD), U1.49 (USB_VDD), U1.56 (VDD), U1.60 (VDD), U1.73 (VDD), U1.80 (VDD), U1.81 (VDD), U1.87 (VDD), U1.101 (VDD), U1.102 (VDD), U1.120 (VDD), U1.126 (VDD)
SYS_3V3: 3V3.T, C1.2, C2.2, C5.2, C8.2, C9.2, C24.2, C39.2, C40.2, C41.2, C42.2, C43.2, C44.2, C45.2, C46.2, C47.2, C48.2, C49.2, C50.2, C51.2, C52.2, C55.2, C56.2, C57.2, C58.2, C59.2, C60.2, C61.2, C64.2, C65.2, C67.2, C70.2, C88.2, C107.2, L1.2, MIC7.1 (VDD), MIC8.1 (VDD), MIC9.1 (VDD), MIC10.1 (VDD), MIC11.1 (VDD), MIC12.1 (VDD), MIC13.1 (VDD), R2.2, R5.2, R15.2, R16.2, R17.2, R21.2, R24.2, R25.2, R27.2, U1.6 (VDDIOL), U1.14 (VDDIOL), U1.19 (VDDIOL), U1.29 (VDDIOL), U1.42 (VDDIOL), U1.44 (USB_VDD33), U1.52 (VDDIOR), U1.67 (VDDIOR), U1.78 (VDDIOR), U1.83 (VDDIOR), U1.92 (VDDIOR), U1.105 (OTP_VCC), U1.110 (VDDIOT), U1.111 (VDDIOT), U4.5 (VCC), U5.6 (VCC), U6.8 (DCVDD), U6.10 (DBVDD), U8.5 (VCC), U9.8 (VCC), U10.8 (VCC), U11.8 (VCC), U12.8 (VCC), X1.1 (ENABLE), X1.4 (VDD), X2.1 (ENABLE), X2.4 (VDD)
TCK: TCK.T, U1.128 (TCK)
TDI: TDI.T, U1.2 (TDI)
TDO: TDO.T, U1.1 (TDO)
TMS: TMS.T, U1.127 (TMS)
USBDM: J2.15, J5.16, R9.1
USBDP: J2.13, J5.14, R8.1
VDD_5V: C3.2, C6.2, C7.2, C10.2, C11.2, C12.2, C13.2, C14.2, C15.2, C16.2, C17.2, C19.2, C21.2, C22.2, C53.2, C54.2, C62.2, C69.2, C72.2, C73.2, C74.2, C75.2, C76.2, C100.1, GND1.T, J1.1 (VCC), J3.2, J6.1, R35.2, R43.1, SK0.4 (VDD), SK1.4 (VDD), SK2.4 (VDD), SK3.4 (VDD), SK4.4 (VDD), SK5.4 (VDD), SK6.4 (VDD), SK7.4 (VDD), SK8.4 (VDD), SK9.4 (VDD), SK10.4 (VDD), SK11.4 (VDD), U1.45 (USB_VBUS), U2.5 (EN), U2.7 (AVIN), U2.8 (PVIN), U3.7 (AVIN), U3.8 (PVIN), U6.21 (SPKVDD2), U6.26 (SPKVDD1), U7.3 (VIN), U13.5 (VCC)
VMID: C4.2, C102.1, TP14.T, U6.27 (VMID)
XL_DN0: U1.9 (X0D41), XL_DN0.T
XL_DN1: U1.8 (X0D40), XL_DN1.T
XL_UP0: R12.2, XL_UP0.T
XL_UP1: R14.2, XL_UP1.T
XSYS_RST_N: J7.1, R2.1, RST_N.T, U4.1 (B)
XUSBDM_N: R9.2, R38.1, U1.47 (USB_DM)
XUSBDP_P: R4.1, R8.2, U1.46 (USB_DP)
_I2S_BCLK: C83.1, R33.1, U6.12 (BCLK)
_I2S_DAC_DATA: C80.1, R41.1, U6.14 (DACDAT)
_I2S_LRCK: C82.1, R40.1, U6.13 (DACLRC)

Notes on the sheet:
fuhua.chen
xCore
Power/Interface
v1.0
Inital release
Microphone Array & LED Array
Clock Sync
And Gate
xCore Peripheral / Power Up Control

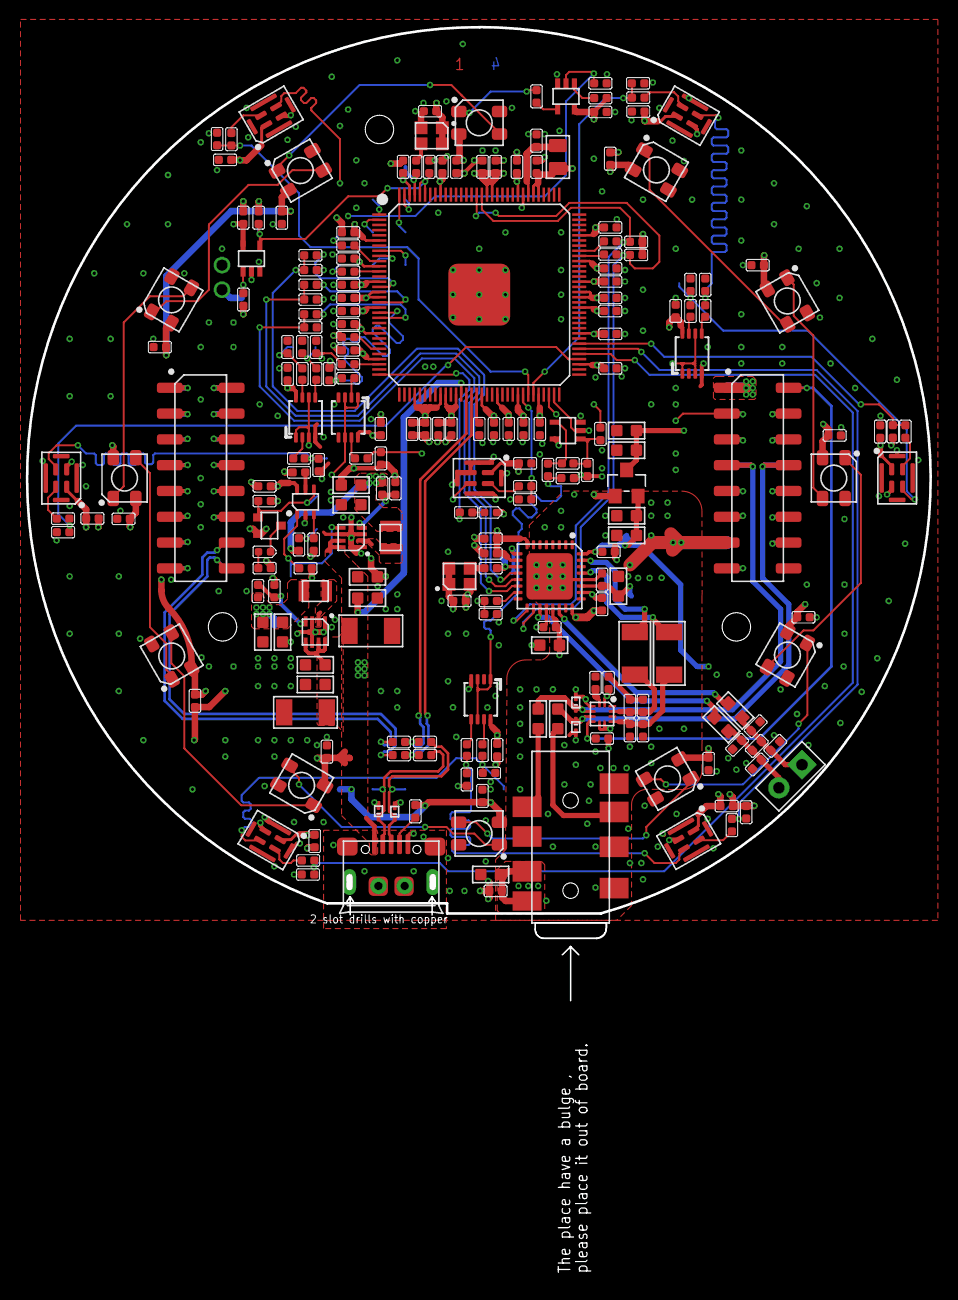
[picture p14: board Respeaker Microphone Array v1.0.brd from above]

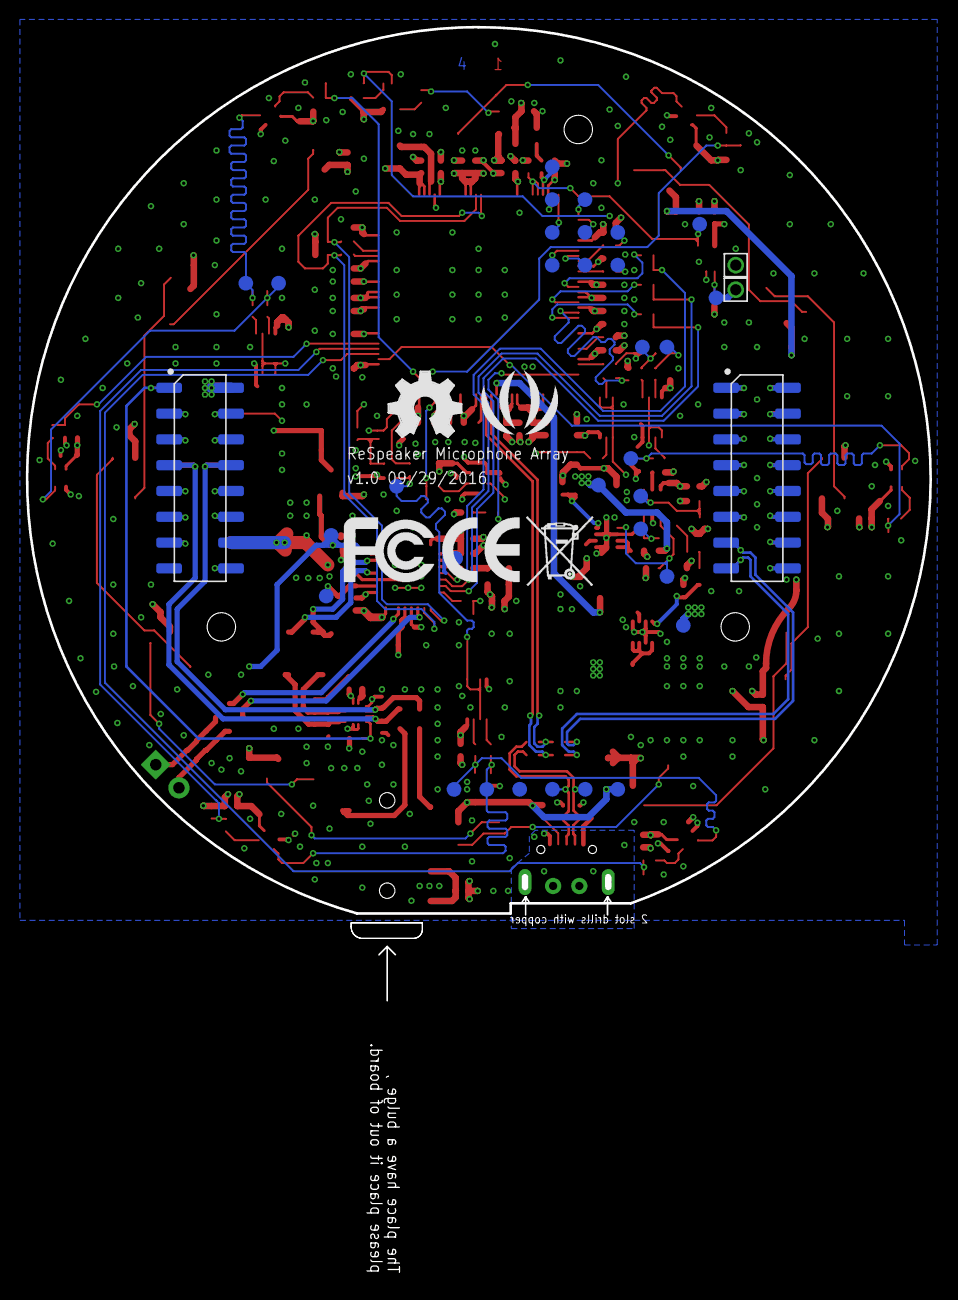
[picture p15: board Respeaker Microphone Array v1.0.brd from below]

Board: 4 copper layers, 70.1 x 75.5 mm, 272 parts (37 on the bottom side), 146 nets.

Other parts of the board:
U$36: OSHW_FILLX200_NOTEXT_TNAME
U$51: SEEED-SILK-TNAME-280*268MIL
