Fuhua-Chen/ReSpeaker_Microphone_Array_SCH_PCB/(notices)

Notices in the files:
parts and their libraries:
moudle-new: This work is licensed under the Creative Commons Attribution 4.0 International License.
To view a copy of this license,visit:
http://creativecommons.org/licenses/by-sa/4.0
moudle-new: CC-BY-SA
